JuanMorency/Project_Sij/README.md

# Project_Sij
Complete 600 mm Frame Drone Electrical and Sotware Design using:

- Atmega2560
- MPU9255
- 4 channel RF receiver
- Flycopter 30A BH-heli motor controllers
- WS2812B LED strips
- Madgwick Sensor Fusion

PCB was designed using Eagle. 

Second iteration of the board with much more processing power for sensor fusion should be considered to continue this project
