JuanMorency/Project_Sij/Materiel et magasinage/Liste_de_materiel.txt

Matériel           Responsable

Batteries           Juan
http://www.hobbyking.com/hobbyking/store/__84112__Multistar_LiHV_High_Capacity_5200Mah_3S_Multi_Rotor_Lipo_Pack_US_Warehouse_.html
Frame               Simon
http://www.hobbyking.com/hobbyking/store/__24227__HobbyKing_X666_Glass_Fiber_Quadcopter_Frame_666mm.html
Hélices             Simon
http://www.hobbyking.com/hobbyking/store/__22453__GWS_Style_Slowfly_Propeller_11x4_7_Green_CW_4pcs_.html
prendre 2 CW 2 CCW
Moteurs             Simon/Juan
http://www.hobbyking.com/hobbyking/store/__25081__NTM_Prop_Drive_Series_28_30S_900kv_270w_short_shaft_version_.html
http://www.hobbyking.com/hobbyking/store/__24527__NTM_Prop_Drive_28_Series_Accessory_Pack_US_Warehouse_.html   (Us warehouse)
ESC                 Simon/Juan
http://www.hobbyking.com/hobbyking/store/__94602__Flycolor_Raptor_Mini_30A_F330_Powered_BLHeli_Multi_Rotor_ESC_2_4S_OPTO_.html
Microcontrolleur    Simon
http://www.digikey.ca/product-detail/en/atmel/ATMEGA2560-16AUR/ATMEGA2560-16AURCT-ND/3789436
Breakout board pour MCU
http://www.robotshop.com/ca/en/cytron-qfp-breakout-board-100-pins.html
IMU                 Juan
http://www.robotshop.com/en/imu-10-dof-16g-3-axis-accelerometer-2000-gyro-magnetometer-barometer.html
RF transmitter/receiver
http://www.hobbyking.com/hobbyking/store/__8338__Hobby_King_2_4Ghz_4Ch_Tx_Rx_V2_Mode_2_.html

Optionnel
GPS chip
Wifi/bluetooth chip
Caméra
LCD (utile pour faire des tests)

Battery charger:
http://www.hobbyking.com/hobbyking/store/__95983__Accucell_S60_AC_Charger_US_Plug_.html

Battery bag:
http://www.hobbyking.com/hobbyking/store/__90280__Turnigy_174_Fire_Retardant_LiPoly_Battery_Bag_Zippered_200x155x95mm_1pc_.html

Connectors:
3.5mm bullet conectors 3*4=12 minimum

Heatshrink:

Programmeur:

http://www.robotshop.com/ca/en/pololu-usb-avr-programmer-v2.html

LED strip:

https://www.aliexpress.com/item/individually-addressable-1m-2m-4m-5m-waterproof-ip65-ip67-5050-rgb-30-60-74-96-144/32243894576.html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

crystal:
https://abra-electronics.com/robotics-embedded-electronics/adafruit/components-parts/oscillators-en/2215-ada-16-mhz-crystal-20pf-capacitors.html
