JuanMorency/Project_Sij/Documentation/RF controller/487627402X1231148X58.pdf

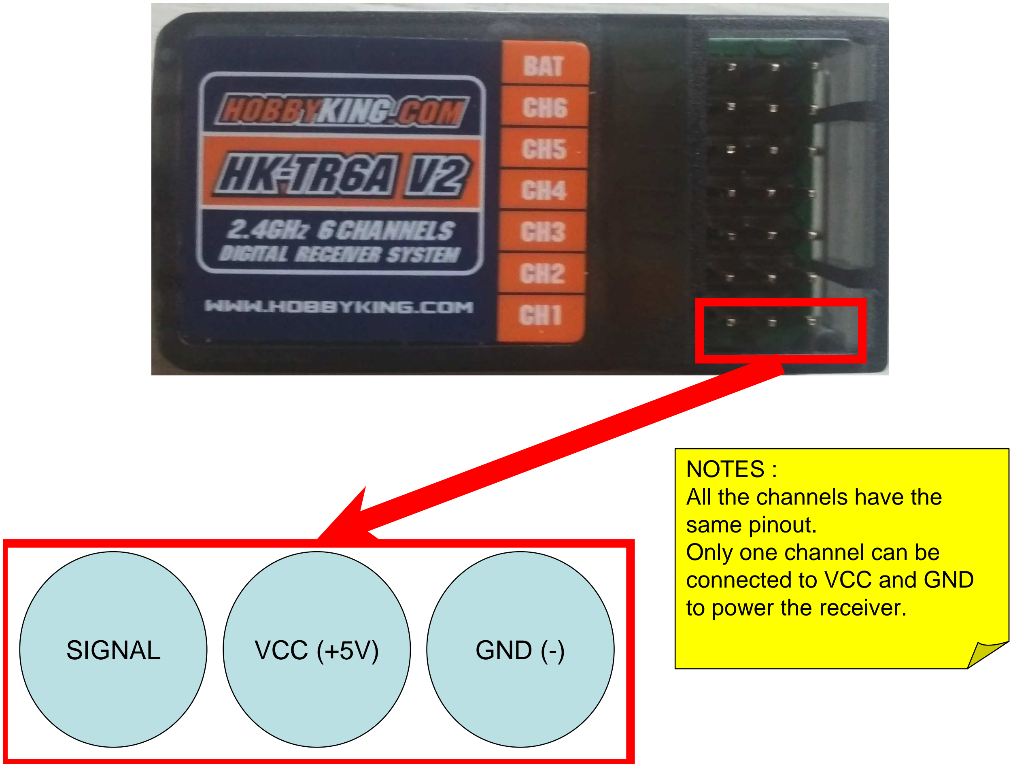
[picture p1: figure]
SIGNAL; VCC (+5V); GND (-); NOTES : All the channels have the same pinout. Only one channel can be connected to VCC and GND to power the receiver.
