JuanMorency/Project_Sij/Eagle/LM5085/2016-09-12_10-49-24/readme.txt

**********************************************************
*************  Important Instructions Follow  ************
**********************************************************

All files exported to: Z:\\43\\47\\4347451\\5\Eagle\2016-09-12_10-49-24\2016-09-12_10-49-24.xml

**********************************************************
*****************Schematic Instructions  *******************
**********************************************************

To import your new Schematic file into Eagle:

1. Unzip the downloaded folder files to local directory and Start Eagle.
2. Select "File"->"Open"->"Schematic..." from the menu at the top of
the screen.
3. Browse to your newly exported file and select the ".sch" file extension.
4. You should now see your schamtic available in Eagle.

**********************************************************
*******************  PCB Instructions  *******************
**********************************************************

To import your new BOARD file into Eagle:

1. Unzip the downloaded folder files to local directory and Start Eagle.
2. Select "File"->"Open"->"Board..." from the menu at the top of
the screen.
3. Browse to your newly exported file and select the ".brd" file extension.
4. Planes will need to be repoured to update the polygon fills
	1. Once your board is loaded and before the repour, the default design rule
	   should be updated for Mask and thermal relief.
		a. Goto Edit and select Design Rules.
			-Select Masks Tab; Set Stop (Min & Max) to 0.0mm
			-Select Supply Tab; Set Thermal Isolation to 0.0mm
	2. To pour the polygon fills, goto Tools and select Ratsnest
	3. The polygons should all be filled now.
5. You should now have an image of your board available in Eagle.

**********************************************************
*******************  LIB Instructions  *******************
**********************************************************

To import your new library into Eagle:

1. Start Eagle.
2. Select "File"->"New"->"Library" from the menu.
3. In the blank library window, select "File" -> "Execute Script"
from the menu.
5. Browse to your newly exported Eagle Script file (".scr" file extension)
6. After opening the file, the script will populate the new library.
Layer 93 should NOT exist.
7. Use "File"->"Save" (or "Save As..") to save the library to the desired
location in Eagle native format.

For additional information, please visit this site:
http://www.accelerated-designs.com/help/Eagle_import.html

You may also find this video helpful:
http://youtu.be/5jGuWY-Yy3Q

**********************************************************
**********************************************************
**********************************************************

Padstack "RX72p08Y137p84D0T" renamed to "RX72p08Y137p84D0"
Padstack "RX420p08Y456p88D0T" renamed to "RX420p08Y456p88D"
Component "GRM188R72E681KW07D" renamed to "GRM188R72E681KW07D"
Component "GRM033R71C102KA01D" renamed to "GRM033R71C102KA01D"
Component "WB_CURRENT_LOAD" renamed to "WB_CURRENT_LOAD"
Component "6TPH100MAEA" renamed to "6TPH100MAEA"
Component "GRM188R61C105KA93D" renamed to "GRM188R61C105KA93D"
Component "MBRB745PBF" renamed to "MBRB745PBF"
Component "WB_GND" renamed to "WB_GND"
Component "XAL6030-222MEB" renamed to "XAL6030-222MEB"
Component "Si7149DP" renamed to "Si7149DP"
Component "CRCW04022K55FKED" renamed to "CRCW04022K55FKED"
Component "CRCW04023K32FKED" renamed to "CRCW04023K32FKED"
Component "CRCW040210K0FKED" renamed to "CRCW040210K0FKED"
Component "CSR1206FK10L0" renamed to "CSR1206FK10L0"
Component "CRCW040226K7FKED" renamed to "CRCW040226K7FKED"
Component "LM5085MY/NOPB" renamed to "LM5085MY/NOPB"
Component "WB_BATTERY" renamed to "WB_BATTERY"
Component "GRM21BR61E475MA12L" renamed to "GRM21BR61E475MA12L"
The Symbol WB_CONTINUATION was missing a RefDes attribute, a refdes was created for the symbol.
The Symbol WB_CONTINUATION was missing a Type attribute, a type was created for the symbol.
The Symbol WB_CONTINUATION was missing a Value attribute, a value was created for the symbol.
The Symbol WB_BLOCK_IO was missing a RefDes attribute, a refdes was created for the symbol.
The Symbol WB_BLOCK_IO was missing a Type attribute, a type was created for the symbol.
The Symbol WB_BLOCK_IO was missing a Value attribute, a value was created for the symbol.
The Symbol WB_PWL_VOLTAGE_SOURCE was missing a RefDes attribute, a refdes was created for the symbol.
The Symbol WB_PWL_VOLTAGE_SOURCE was missing a Type attribute, a type was created for the symbol.
The Symbol WB_PWL_VOLTAGE_SOURCE was missing a Value attribute, a value was created for the symbol.
The Symbol WB_SOURCE_RESISTOR was missing a RefDes attribute, a refdes was created for the symbol.
The Symbol WB_SOURCE_RESISTOR was missing a Type attribute, a type was created for the symbol.
The Symbol WB_SOURCE_RESISTOR was missing a Value attribute, a value was created for the symbol.
The Symbol WB_PRIM_PWL_VOLTAGE_SOURCE was missing a RefDes attribute, a refdes was created for the symbol.
The Symbol WB_PRIM_PWL_VOLTAGE_SOURCE was missing a Type attribute, a type was created for the symbol.
The Symbol WB_PRIM_PWL_VOLTAGE_SOURCE was missing a Value attribute, a value was created for the symbol.
The Symbol WB_CURRENT_PROBE was missing a RefDes attribute, a refdes was created for the symbol.
The Symbol WB_CURRENT_PROBE was missing a Type attribute, a type was created for the symbol.
The Symbol WB_CURRENT_PROBE was missing a Value attribute, a value was created for the symbol.
The Symbol WB_LOAD_RESISTOR was missing a RefDes attribute, a refdes was created for the symbol.
The Symbol WB_LOAD_RESISTOR was missing a Type attribute, a type was created for the symbol.
The Symbol WB_LOAD_RESISTOR was missing a Value attribute, a value was created for the symbol.
The Symbol WB_PRIM_STARTUP_VOLTAGE_SOURCE was missing a RefDes attribute, a refdes was created for the symbol.
The Symbol WB_PRIM_STARTUP_VOLTAGE_SOURCE was missing a Type attribute, a type was created for the symbol.
The Symbol WB_PRIM_STARTUP_VOLTAGE_SOURCE was missing a Value attribute, a value was created for the symbol.
The Symbol WB_STARTUP_VOLTAGE_SOURCE was missing a RefDes attribute, a refdes was created for the symbol.
The Symbol WB_STARTUP_VOLTAGE_SOURCE was missing a Type attribute, a type was created for the symbol.
The Symbol WB_STARTUP_VOLTAGE_SOURCE was missing a Value attribute, a value was created for the symbol.
The Symbol WB_PWL_CURRENT_LOAD was missing a RefDes attribute, a refdes was created for the symbol.
The Symbol WB_PWL_CURRENT_LOAD was missing a Type attribute, a type was created for the symbol.
The Symbol WB_PWL_CURRENT_LOAD was missing a Value attribute, a value was created for the symbol.
The Symbol WB_PRIMITIVE_BATTERY was missing a RefDes attribute, a refdes was created for the symbol.
The Symbol WB_PRIMITIVE_BATTERY was missing a Type attribute, a type was created for the symbol.
The Symbol WB_PRIMITIVE_BATTERY was missing a Value attribute, a value was created for the symbol.
The Symbol WB_CFF_BLOCK was missing a RefDes attribute, a refdes was created for the symbol.
The Symbol WB_CFF_BLOCK was missing a Type attribute, a type was created for the symbol.
The Symbol WB_CFF_BLOCK was missing a Value attribute, a value was created for the symbol.
The Symbol WB_CAP_OUTPUT was missing a RefDes attribute, a refdes was created for the symbol.
The Symbol WB_CAP_OUTPUT was missing a Type attribute, a type was created for the symbol.
The Symbol WB_CAP_OUTPUT was missing a Value attribute, a value was created for the symbol.
The Symbol WB_DIODE_SCHOTTKY was missing a RefDes attribute, a refdes was created for the symbol.
The Symbol WB_DIODE_SCHOTTKY was missing a Type attribute, a type was created for the symbol.
The Symbol WB_DIODE_SCHOTTKY was missing a Value attribute, a value was created for the symbol.
The Symbol WB_P_MOSFET was missing a RefDes attribute, a refdes was created for the symbol.
The Symbol WB_P_MOSFET was missing a Type attribute, a type was created for the symbol.
The Symbol WB_P_MOSFET was missing a Value attribute, a value was created for the symbol.
The Symbol WB_LM5085 was missing a RefDes attribute, a refdes was created for the symbol.
The Symbol WB_LM5085 was missing a Type attribute, a type was created for the symbol.
The Symbol WB_LM5085 was missing a Value attribute, a value was created for the symbol.
The Symbol WB_VOLTAGE_PROBE was missing a RefDes attribute, a refdes was created for the symbol.
The Symbol WB_VOLTAGE_PROBE was missing a Type attribute, a type was created for the symbol.
The Symbol WB_VOLTAGE_PROBE was missing a Value attribute, a value was created for the symbol.
The Symbol LM5085MY/NOPB was missing a Value attribute, a value was created for the symbol.

Ultra Librarian Gold 8.1.44 Process Report

Message - Padstack "RX26Y38D0T" Shape(4) is a CIRCLE with no diameter.
Message - Padstack "RX14Y13D0T" Shape(4) is a CIRCLE with no diameter.
Message - Padstack "RX44Y57D0T" Shape(4) is a CIRCLE with no diameter.
Message - Padstack "RX63Y55D0T" Shape(4) is a CIRCLE with no diameter.
Message - Padstack "RX72p08Y137p84D0" Shape(4) is a CIRCLE with no diameter.
Message - Padstack "RX420p08Y456p88D" Shape(4) is a CIRCLE with no diameter.
Message - Padstack "RX56Y224D0T" Shape(4) is a CIRCLE with no diameter.
Message - Padstack "RX40Y20D0T" Shape(4) is a CIRCLE with no diameter.
Message - Padstack "RX127Y157D0T" Shape(4) is a CIRCLE with no diameter.
Message - Padstack "RX22Y24D0T" Shape(4) is a CIRCLE with no diameter.
Message - Padstack "RX44Y71D0T" Shape(4) is a CIRCLE with no diameter.
Message - Padstack "RX54Y18D0TSM2" Shape(4) is a CIRCLE with no diameter.
Message - Padstack "RX54Y18D0T" Shape(4) is a CIRCLE with no diameter.
Message - Padstack "RX74Y79D0T" Shape(4) is a CIRCLE with no diameter.
Message - Component "GRM188R72E681KW07D" attribute "Cap" references text style "" that is not in the database.
The default pattern text style "H50s3" was substituted.
Message - Component "GRM188R72E681KW07D" attribute "ESR" references text style "" that is not in the database.
The default pattern text style "H50s3" was substituted.
Message - Component "GRM188R72E681KW07D" attribute "IRMS" references text style "" that is not in the database.
The default pattern text style "H50s3" was substituted.
Message - Component "GRM188R72E681KW07D" attribute "VDC" references text style "" that is not in the database.
The default pattern text style "H50s3" was substituted.
Message - Component "GRM033R71C102KA01D" attribute "Cap" references text style "" that is not in the database.
The default pattern text style "H50s3" was substituted.
Message - Component "GRM033R71C102KA01D" attribute "ESR" references text style "" that is not in the database.
The default pattern text style "H50s3" was substituted.
Message - Component "GRM033R71C102KA01D" attribute "IRMS" references text style "" that is not in the database.
The default pattern text style "H50s3" was substituted.
Message - Component "GRM033R71C102KA01D" attribute "VDC" references text style "" that is not in the database.
The default pattern text style "H50s3" was substituted.
Message - Component "6TPH100MAEA" attribute "Datasheet URL" references text style "" that is not in the database.
The default pattern text style "H50s3" was substituted.
Message - Component "6TPH100MAEA" attribute "Cap" references text style "" that is not in the database.
The default pattern text style "H50s3" was substituted.
Message - Component "6TPH100MAEA" attribute "ESR" references text style "" that is not in the database.
The default pattern text style "H50s3" was substituted.
Message - Component "6TPH100MAEA" attribute "IRMS" references text style "" that is not in the database.
The default pattern text style "H50s3" was substituted.
Message - Component "6TPH100MAEA" attribute "VDC" references text style "" that is not in the database.
The default pattern text style "H50s3" was substituted.
Message - Component "GRM188R61C105KA93D" attribute "Cap" references text style "" that is not in the database.
The default pattern text style "H50s3" was substituted.
Message - Component "GRM188R61C105KA93D" attribute "ESR" references text style "" that is not in the database.
The default pattern text style "H50s3" was substituted.
Message - Component "GRM188R61C105KA93D" attribute "IRMS" references text style "" that is not in the database.
The default pattern text style "H50s3" was substituted.
Message - Component "GRM188R61C105KA93D" attribute "VDC" references text style "" that is not in the database.
The default pattern text style "H50s3" was substituted.
Message - Component "MBRB745PBF" attribute "Datasheet URL" references text style "" that is not in the database.
The default pattern text style "H50s3" was substituted.
Message - Component "MBRB745PBF" attribute "Io" references text style "" that is not in the database.
The default pattern text style "H50s3" was substituted.
Message - Component "MBRB745PBF" attribute "VRRM" references text style "" that is not in the database.
The default pattern text style "H50s3" was substituted.
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
Message - Component "LM5085MY/NOPB" attribute "Datasheet URL" references text style "" that is not in the database.
The default pattern text style "H50s3" was substituted.
Message - Component "LM5085MY/NOPB" attribute "Frequency" references text style "" that is not in the database.
The default pattern text style "H50s3" was substituted.
Message - Component "LM5085MY/NOPB" attribute "Imax" references text style "" that is not in the database.
The default pattern text style "H50s3" was substituted.
Message - Component "LM5085MY/NOPB" attribute "Package" references text style "" that is not in the database.
The default pattern text style "H50s3" was substituted.
Message - Component "LM5085MY/NOPB" attribute "Mktg_Package" references text style "" that is not in the database.
The default pattern text style "H50s3" was substituted.
Message - Component "LM5085MY/NOPB" attribute "NSID" references text style "" that is not in the database.
The default pattern text style "H50s3" was substituted.
Message - Component "GRM21BR61E475MA12L" attribute "Datasheet URL" references text style "" that is not in the database.
The default pattern text style "H50s3" was substituted.
Message - Component "GRM21BR61E475MA12L" attribute "Cap" references text style "" that is not in the database.
The default pattern text style "H50s3" was substituted.
Message - Component "GRM21BR61E475MA12L" attribute "ESR" references text style "" that is not in the database.
The default pattern text style "H50s3" was substituted.
Message - Component "GRM21BR61E475MA12L" attribute "IRMS" references text style "" that is not in the database.
The default pattern text style "H50s3" was substituted.
Message - Component "GRM21BR61E475MA12L" attribute "VDC" references text style "" that is not in the database.
The default pattern text style "H50s3" was substituted.

TextStyle count:  24
Padstack count:   14
Pattern count:    10
Symbol count:     27
Component count:  17

Export

Footprint "WB_CURRENT_LOAD" has no layer data mapped and will be skipped.
Component "WB_CURRENT_LOAD" requires footprint "WB_CURRENT_LOAD" and will be skipped.
Footprint "WB_GND" has no layer data mapped and will be skipped.
Component "WB_GND" requires footprint "WB_GND" and will be skipped.
Footprint "WB_BATTERY" has no layer data mapped and will be skipped.
Component "WB_BATTERY" requires footprint "WB_BATTERY" and will be skipped.
