JuanMorency/Project_Sij/Documentation/pushButton.pdf

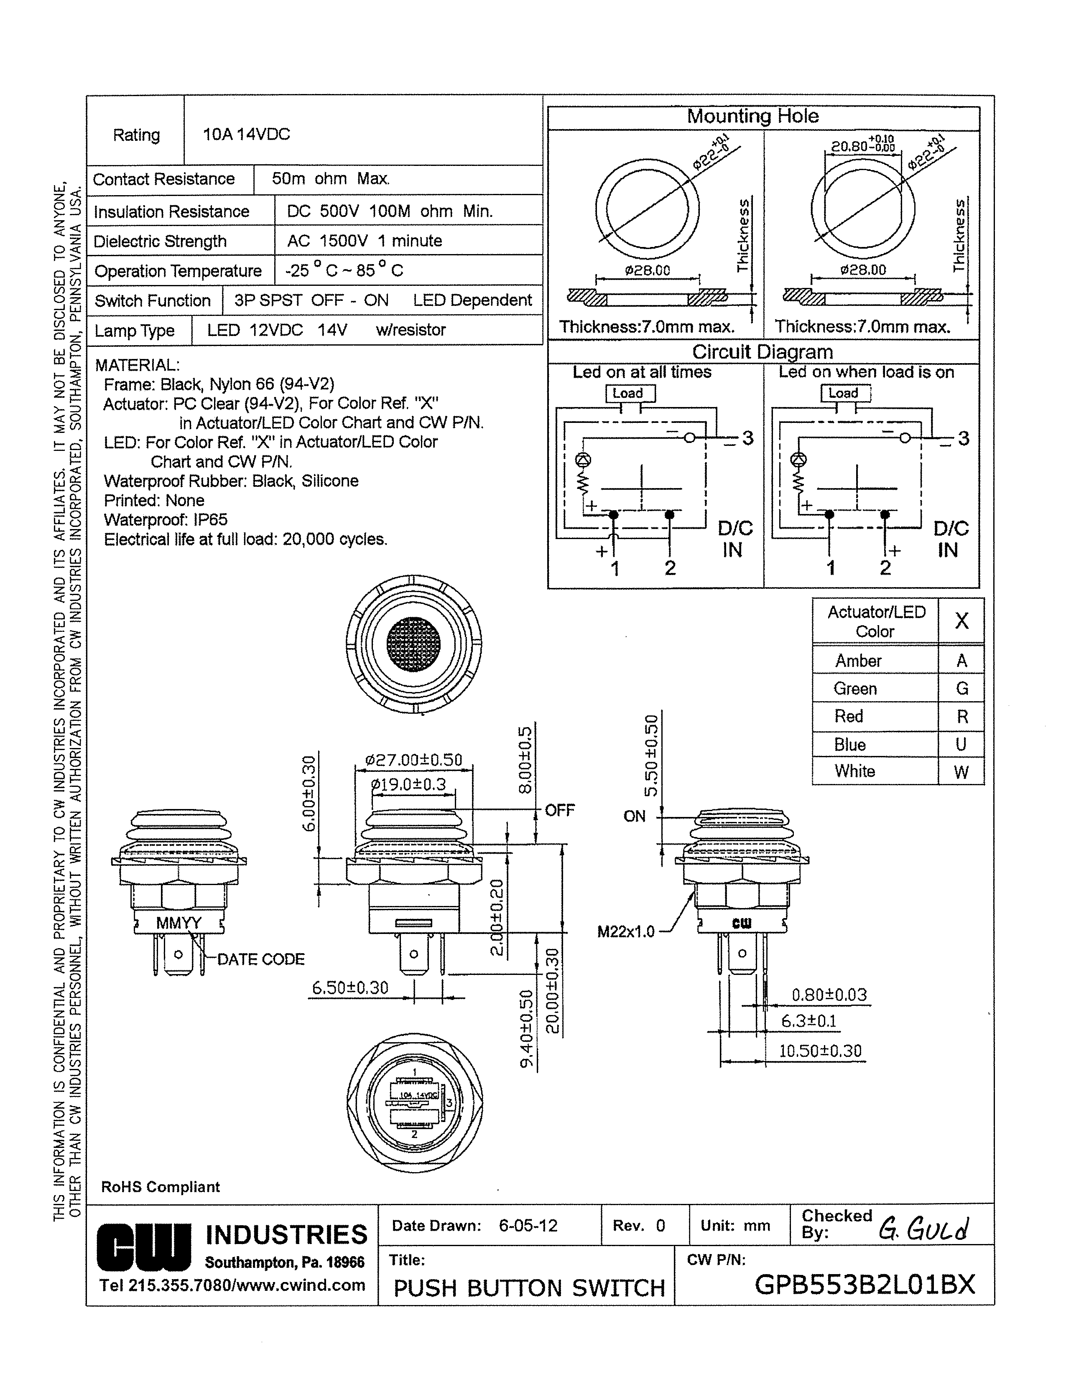
[picture p2: page 1]
