JuanMorency/Project_Sij/Documentation/Coding/filePathMacro.png

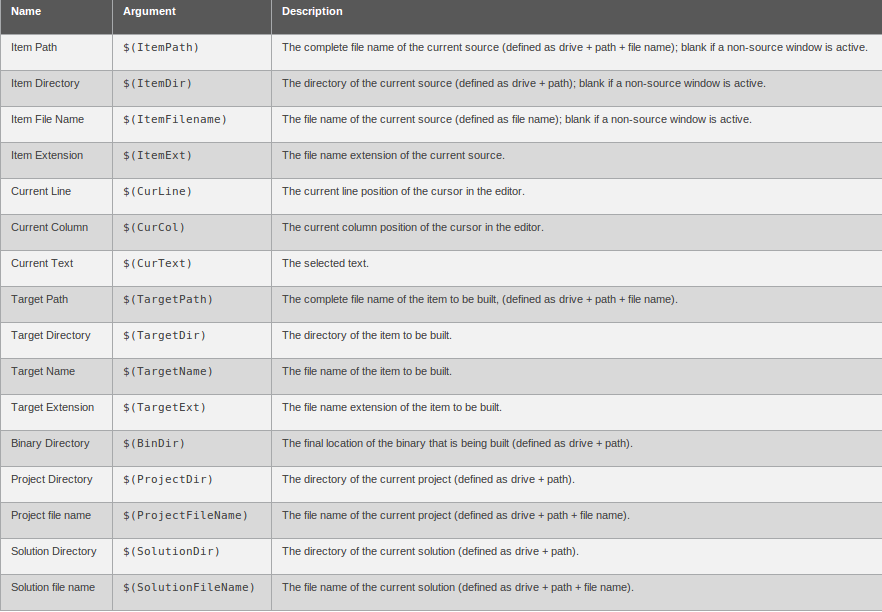
Documentation/Coding/filePathMacro.png
