JuanMorency/Project_Sij/Eagle/Shots/Bottom.PNG

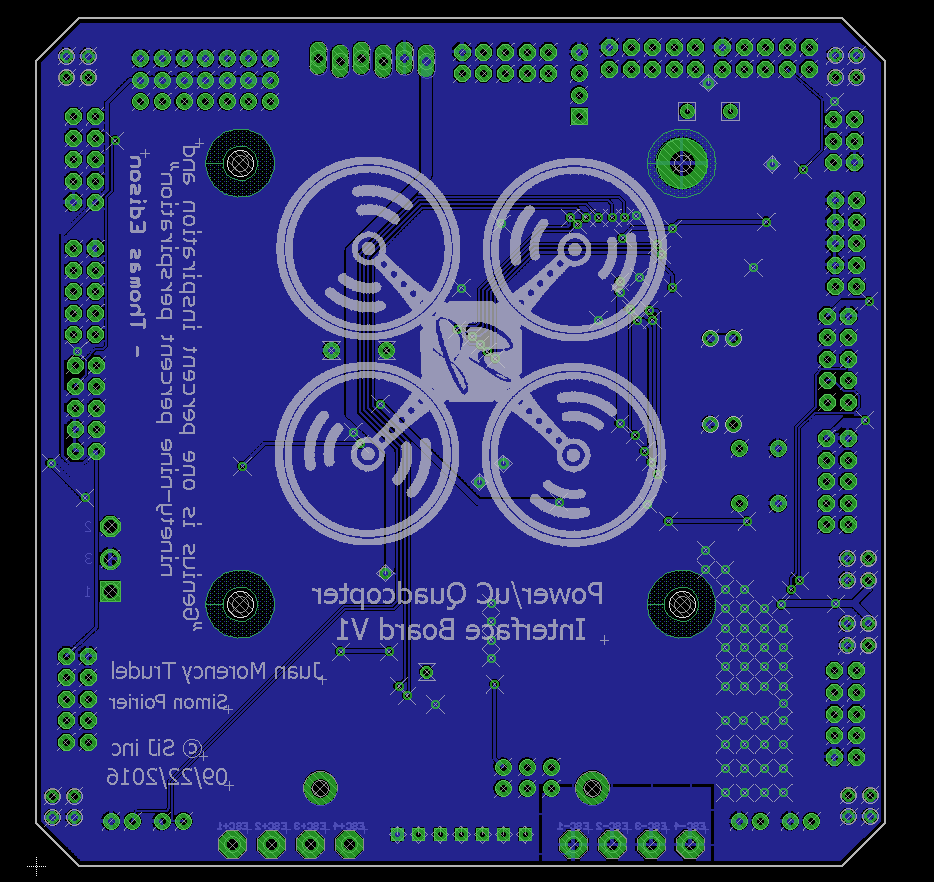
Eagle/Shots/Bottom.PNG
