JuanMorency/Project_Sij/Eagle/Shots/bottom_top.PNG

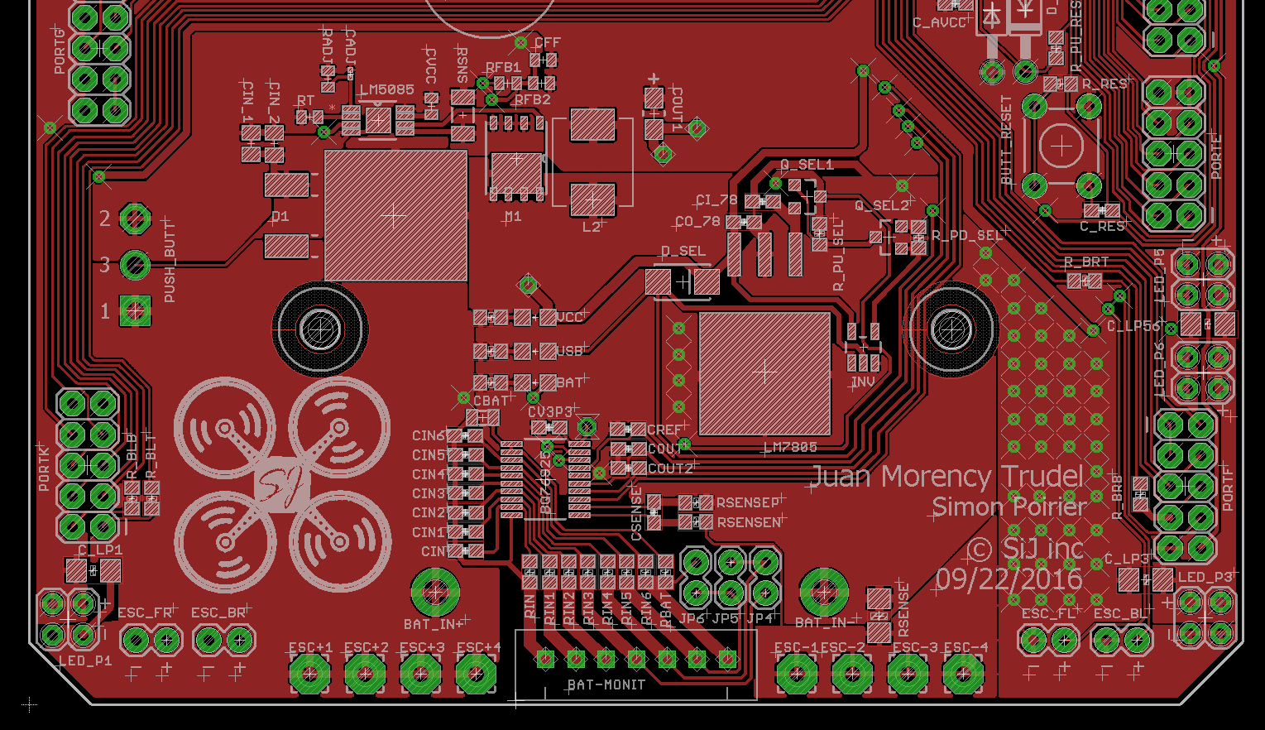
Eagle/Shots/bottom_top.PNG
