JuanMorency/Project_Sij/Eagle/Shots/full_top.PNG

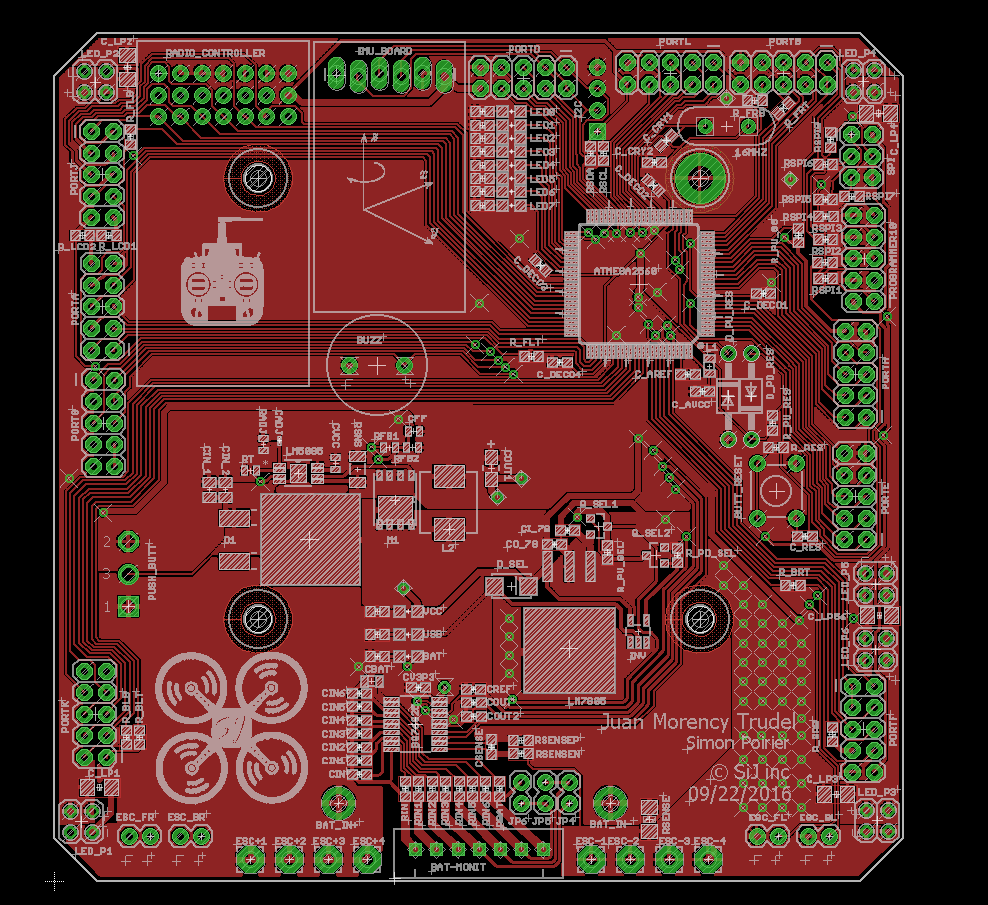
Eagle/Shots/full_top.PNG
