JuanMorency/Project_Sij/Eagle/Shots/top_top.PNG

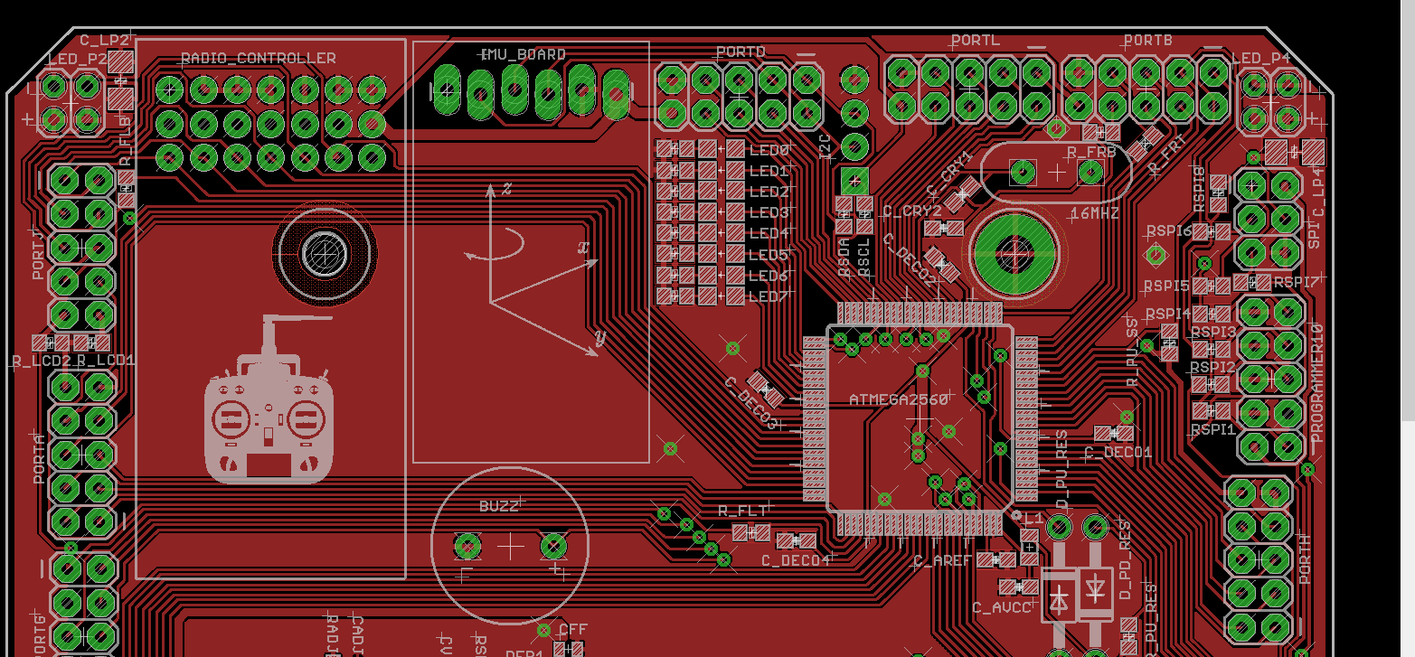
Eagle/Shots/top_top.PNG
