JuanMorency/Project_Sij/Materiel et magasinage/liste_comp_manquante.xlsx

Part | Value | Device | Package | Library | Ordered
16MHZ | 16MHz | CRYSTALHC49US | HC49US | SparkFun-FreqCtrl | y
ATMEGA2560 | ATMEGA2560AU | ATMEGA2560AU | TQFP100 | SparkFun-DigitalIC | y
BAT |  | LEDCHIPLED_0805 | CHIPLED_0805 | led
BAT-MONIT | 7_PIN_JST-XH | 7_PIN_JST-XH | 7_PIN_JST-XH | JST-XH_HEADERS | y
BAT_IN+ | AWG_10_HOLE_PAD | AWG_10_HOLE_PAD | AWG10_HOLE_PAD | custom_parts | y
BAT_IN- | AWG_10_HOLE_PAD | AWG_10_HOLE_PAD | AWG10_HOLE_PAD | custom_parts | y
BQ76925 | BQ76925_PW_20 | BQ76925_PW_20 | PW20 | TI | y
BUTT_RESET | SWITCH-MOMENTARY-2PTH | SWITCH-MOMENTARY-2PTH | TACTILE-PTH | SparkFun-Electromechanical | y
BUZZ | BUZZERPTH | BUZZERPTH | BUZZER-12MM | SparkFun-Electromechanical | y
CADJ | 1nF | GRM033R71C102KA01D | 201 | LM5085 | y
CBAT | 10uF | CAP0805 | 805 | SparkFun-Capacitors | y
CFF | 680pF | GRM188R72E681KW07D | 603 | LM5085
CIN | 1.0uF | 1.0UF-16V-10%(0603) | 0603-CAP | SparkFun-Capacitors | y
CIN1 | 1.0uF | 1.0UF-16V-10%(0603) | 0603-CAP | SparkFun-Capacitors | y
CIN2 | 1.0uF | 1.0UF-16V-10%(0603) | 0603-CAP | SparkFun-Capacitors | y
CIN3 | 1.0uF | 1.0UF-16V-10%(0603) | 0603-CAP | SparkFun-Capacitors | y
CIN4 | 1.0uF | 1.0UF-16V-10%(0603) | 0603-CAP | SparkFun-Capacitors | y
CIN5 | 1.0uF | 1.0UF-16V-10%(0603) | 0603-CAP | SparkFun-Capacitors | y
CIN6 | 1.0uF | 1.0UF-16V-10%(0603) | 0603-CAP | SparkFun-Capacitors | y
CIN_1 | 4.7uF | GRM21BR61E475MA12L | 805 | LM5085 | l
CIN_2 | 4.7uF | GRM21BR61E475MA12L | 805 | LM5085 | l
CI_78 | 0.22uF | 0.22UF-25V-10%(0603) | 0603-CAP | SparkFun-Capacitors | y
COUT | 0.1u | CAP0603-CAP | 0603-CAP | SparkFun-Capacitors | y
COUT1 | 100uF | 6TPH100MAEA | CAPSMT_6_A09 | LM5085 | l
COUT2 | 1.0uF | 1.0UF-16V-10%(0603) | 0603-CAP | SparkFun-Capacitors | y
CO_78 | 0.1uF | 0.1UF-25V-5%(0603) | 0603-CAP | SparkFun-Capacitors | y
CREF | 1.0uF | 1.0UF-16V-10%(0603) | 0603-CAP | SparkFun-Capacitors | y
CSENSE | 0.1u | CAP0603-CAP | 0603-CAP | SparkFun-Passives | y
CV3P3 | 4.7uF | 4.7UF-6.3V-10%(0603)0603 | 0603-CAP | SparkFun-Capacitors | y
CVCC | 1uF | GRM188R61C105KA93D | 603 | LM5085 | y
C_AREF | 0.1u | CAP0603-CAP | 0603-CAP | SparkFun-Capacitors | y
C_AVCC | 0.1u | CAP0603-CAP | 0603-CAP | SparkFun-Capacitors | y
C_CRY1 | 22pF | 22PF-50V-5%(0603) | 0603-CAP | SparkFun-Capacitors | l
C_CRY2 | 22pF | 22PF-50V-5%(0603) | 0603-CAP | SparkFun-Capacitors | l
C_DECO1 | 0.1uF | 0.1UF-25V-5%(0603) | 0603-CAP | SparkFun-Capacitors | y
C_DECO2 | 0.1uF | 0.1UF-25V-5%(0603) | 0603-CAP | SparkFun-Capacitors | y
C_DECO3 | 0.1uF | 0.1UF-25V-5%(0603) | 0603-CAP | SparkFun-Capacitors | y
C_DECO4 | 0.1uF | 0.1UF-25V-5%(0603) | 0603-CAP | SparkFun-Capacitors | y
C_LP1 | 100uF | CAP1206 | 1206 | SparkFun-Capacitors | l
C_LP2 | 100uF | CAP1206 | 1206 | SparkFun-Capacitors | l
C_LP3 | 100uF | CAP1206 | 1206 | SparkFun-Capacitors | l
C_LP4 | 100uF | CAP1206 | 1206 | SparkFun-Capacitors | l
C_LP56 | 100uF | CAP1206 | 1206 | SparkFun-Capacitors | l
C_RES | 0.1uF | 0.1UF-25V-5%(0603) | 0603-CAP | SparkFun-Capacitors | y
D1 | 700mV | MBRB745PBF | DDPAK | LM5085 | l
D_PD_RES | 1N4004 | 1N4004 | DO41-10 | diode | y
D_PU_RES | 1N4004 | 1N4004 | DO41-10 | diode | y
D_SEL | CDBA320L | DIODESMA-ALT | SMA-DIODE_ALT | SparkFun-DiscreteSemi | y
ESC+1 | WIREPAD3,17/1,3 | WIREPAD3,17/1,3 | 3,17/1,3 | wirepad | y
ESC+2 | WIREPAD3,17/1,3 | WIREPAD3,17/1,3 | 3,17/1,3 | wirepad | y
ESC+3 | WIREPAD3,17/1,3 | WIREPAD3,17/1,3 | 3,17/1,3 | wirepad | y
ESC+4 | WIREPAD3,17/1,3 | WIREPAD3,17/1,3 | 3,17/1,3 | wirepad | y
ESC-1 | WIREPAD3,17/1,3 | WIREPAD3,17/1,3 | 3,17/1,3 | wirepad | y
ESC-2 | WIREPAD3,17/1,3 | WIREPAD3,17/1,3 | 3,17/1,3 | wirepad | y
ESC-3 | WIREPAD3,17/1,3 | WIREPAD3,17/1,3 | 3,17/1,3 | wirepad | y
ESC-4 | WIREPAD3,17/1,3 | WIREPAD3,17/1,3 | 3,17/1,3 | wirepad | y
ESC_BL | 640455_TE_connectivity | M02PTH | 1X02 | SparkFun-Connectors | y
ESC_BR | 640455_TE_connectivity | M02PTH | 1X02 | SparkFun-Connectors | y
ESC_FL | 640455_TE_connectivity | M02PTH | 1X02 | SparkFun-Connectors | y
ESC_FR | 640455_TE_connectivity | M02PTH | 1X02 | SparkFun-Connectors | y
H4 | MOUNT-PAD-ROUND3.0 | MOUNT-PAD-ROUND3.0 | 3,0-PAD | holes | y
I2C |  | M041X04_NO_SILK | 1X04_NO_SILK | SparkFun-Connectors | l
IMU_BOARD | M06_IMU | M06_IMU | 1X06_LONGPADS | custom_parts | y
INV | TC7SU04F | INVERTER_SOT23-5 | SOT23-5 | SparkFun-DigitalIC | y
JP4 |  | JUMPER-2PTH | 1X02 | SparkFun-Retired | l
JP5 |  | JUMPER-2PTH | 1X02 | SparkFun-Retired | l
JP6 |  | JUMPER-2PTH | 1X02 | SparkFun-Retired | l
L1 | 10uH | INDUCTOR0805 | 805 | SparkFun-Passives | y
L2 | 2.2uH | IND_MGV0605 | MGV0605 | custom_parts | l
LED0 |  | LEDCHIPLED_0805 | CHIPLED_0805 | led | y
LED1 |  | LEDCHIPLED_0805 | CHIPLED_0805 | led | y
LED2 |  | LEDCHIPLED_0805 | CHIPLED_0805 | led | y
LED3 |  | LEDCHIPLED_0805 | CHIPLED_0805 | led | y
LED4 |  | LEDCHIPLED_0805 | CHIPLED_0805 | led | y
LED5 |  | LEDCHIPLED_0805 | CHIPLED_0805 | led | y
LED6 |  | LEDCHIPLED_0805 | CHIPLED_0805 | led | y
LED7 |  | LEDCHIPLED_0805 | CHIPLED_0805 | led | y
LED_P1 | MALE_HEADER | PINHD-2X2 | 2X02 | pinhead | y
LED_P2 | MALE_HEADER | PINHD-2X2 | 2X02 | pinhead | y
LED_P3 | MALE_HEADER | PINHD-2X2 | 2X02 | pinhead | y
LED_P4 | MALE_HEADER | PINHD-2X2 | 2X02 | pinhead | y
LED_P5 | MALE_HEADER | PINHD-2X2 | 2X02 | pinhead | l
LED_P6 | MALE_HEADER | PINHD-2X2 | 2X02 | pinhead | l
LM5085 | LM5085MY/NOPB | LM5085MY/NOPB | MUY08A | LM5085 | y
LM7805 | LM7805 | LM7805 | KTT3 | TI | y
M1 | -30V | SI7149DP | POWERPAK_SO-8 | LM5085 | l
PORTA |  | M05X2PTH | AVR_ICSP | SparkFun-Connectors | y
PORTB |  | M05X2PTH | AVR_ICSP | SparkFun-Connectors | y
PORTD |  | M05X2PTH | AVR_ICSP | SparkFun-Connectors | y
PORTE |  | M05X2PTH | AVR_ICSP | SparkFun-Connectors | y
PORTF |  | M05X2PTH | AVR_ICSP | SparkFun-Connectors | y
PORTG |  | M05X2PTH | AVR_ICSP | SparkFun-Connectors | y
PORTH |  | M05X2PTH | AVR_ICSP | SparkFun-Connectors | y
PORTJ |  | M05X2PTH | AVR_ICSP | SparkFun-Connectors | y
PORTK |  | M05X2PTH | AVR_ICSP | SparkFun-Connectors | y
PORTL |  | M05X2PTH | AVR_ICSP | SparkFun-Connectors | y
PROGRAMMER10 |  | M05X2PTH | AVR_ICSP | SparkFun-Connectors | y
PUSH_BUTT | PUSH_BUTTON | PUSH_BUTTON | PUSH_BUTTON | custom_parts | l
Q_SEL1 | DMN3099L | MOSFET-PCHANNEL | SOT23-3 | SparkFun-DiscreteSemi | y
Q_SEL2 | DMN3023L | MOSFET-NCHANNELAO3404A | SOT23-3 | SparkFun-DiscreteSemi | y
RADIO_CONTROLLER | RF_CONTROL_3X7_CON | RF_CONTROL_3X7_CON | 3X07 | custom_parts | y
RADJ | 2.55k | CRCW04022K55FKED | 603 | LM5085 | l
RBAT | 100 | R-US_R0603 | R0603 | resistor | y
RFB1 | 3.32k | CRCW04023K32FKED | 603 | LM5085 | l
RFB2 | 10k | CRCW040210K0FKED | 603 | LM5085 | y
RIN | 100 | R-US_R0603 | R0603 | resistor | y
RIN1 | 100 | R-US_R0603 | R0603 | resistor | y
RIN2 | 100 | R-US_R0603 | R0603 | resistor | y
RIN3 | 100 | R-US_R0603 | R0603 | resistor | y
RIN4 | 100 | R-US_R0603 | R0603 | resistor | y
RIN5 | 100 | R-US_R0603 | R0603 | resistor | y
RIN6 | 100 | R-US_R0603 | R0603 | resistor | y
RLED0 |  | R-US_R0603 | R0603 | resistor | y
RLED1 |  | R-US_R0603 | R0603 | resistor | y
RLED2 |  | R-US_R0603 | R0603 | resistor | y
RLED3 |  | R-US_R0603 | R0603 | resistor | y
RLED4 |  | R-US_R0603 | R0603 | resistor | y
RLED5 |  | R-US_R0603 | R0603 | resistor | y
RLED6 |  | R-US_R0603 | R0603 | resistor | y
RLED7 |  | R-US_R0603 | R0603 | resistor | y
RSCL | 2K | R-US_R0603 | R0603 | resistor | y
RSDA | 2K | R-US_R0603 | R0603 | resistor | y
RSENSE | 1m | R-US_R1206 | R1206 | resistor | y
RSENSEN | 1K | R-US_R0603 | R0603 | resistor | y
RSENSEP | 1K | R-US_R0603 | R0603 | resistor | y
RSNS | 10m | CSR1206FK10L0 | 1206 | LM5085 | l
RSPI1 | 500 | R-US_R0603 | R0603 | resistor | n
RSPI2 | 500 | R-US_R0603 | R0603 | resistor | n
RSPI3 | 500 | R-US_R0603 | R0603 | resistor | n
RSPI4 | 500 | R-US_R0603 | R0603 | resistor | n
RSPI5 | 500 | R-US_R0603 | R0603 | resistor | n
RSPI6 | 500 | R-US_R0603 | R0603 | resistor | n
RSPI7 | 500 | R-US_R0603 | R0603 | resistor | n
RSPI8 | 500 | R-US_R0603 | R0603 | resistor | n
RT | 26.7k | CRCW040226K7FKED | 603 | LM5085 | l
R_BAT | to_calc | R-US_R0603 | R0603 | resistor | y
R_BLB | 220 | R-US_R0603 | R0603 | resistor | y
R_BLT | 220 | R-US_R0603 | R0603 | resistor | y
R_BRB | 220 | R-US_R0603 | R0603 | resistor | y
R_BRT | 220 | R-US_R0603 | R0603 | resistor | y
R_FLB | 220 | R-US_R0603 | R0603 | resistor | y
R_FLT | 220 | R-US_R0603 | R0603 | resistor | y
R_FRB | 220 | R-US_R0603 | R0603 | resistor | y
R_FRT | 220 | R-US_R0603 | R0603 | resistor | y
R_LCD1 | 2k | R-US_R0603 | R0603 | resistor | y
R_LCD2 | 500 | R-US_R0603 | R0603 | resistor | n
R_PD_SEL | 10K | R-US_R0603 | R0603 | resistor | y
R_PU_RES | 4.7k | R-US_R0603 | R0603 | resistor | y
R_PU_SEL | 10K | R-US_R0603 | R0603 | resistor | y
R_PU_SS | 4.7k | R-US_R0603 | R0603 | resistor | y
R_RES | 363 | R-US_R0603 | R0603 | resistor | y
R_USB | to_calc | R-US_R0603 | R0603 | resistor | y
R_VCC | to_calc | R-US_R0603 | R0603 | resistor | y
SPI | FEMALE 2x3 | M03X2FEMALE | 2X3 | SparkFun-Connectors | y
USB |  | LEDCHIPLED_0805 | CHIPLED_0805 | led | y
VCC |  | LEDCHIPLED_0805 | CHIPLED_0805 | led | y
