JuanMorency/Project_Sij/(list of files, cad)

Other CAD files:
Code/ExamplesCode/MPU9255-master/i2cdevlib-master/i2cdevlib-master/PIC18/MPU6050/Examples/MPU6050_raw.X/l.obj
