JuanMorency/Project_Sij/Documentation/Coding/Git_merging_tutorial.txt

httpsgit-scm.combookenv2Git-Branching-Basic-Branching-and-Merging
