JuanMorency/Project_Sij/TODO.txt

PCB 

- Verifier le circuit pour le 5V switching regulator. Il fait un bruit aigu et perds en voltage lorsqu'on connecte un load
- Essayer d'arranger le power monitoring I2C en testant sur un un autre board avec notre spare microcontroller

Code

- Voir à rendre le I2C plus robuste.

- Verifier la pertinence d'activer les nested interrupts

- créer des fonctions pour désactiver certain interrupts

- check if we should have some kind of protection when we write 2 bytes in case an interrupt happend in between 
and reads the wrong value.

- Adjust Low pass filter and sampling rate of the accelerometer/gyro.

- Calibration et calculs pour les 3 senseurs
