JuanMorency/Project_Sij/Documentation/documentation-10-dof-imu-sensor-b/10-DOF-IMU-Sensor-B-Schematic.pdf

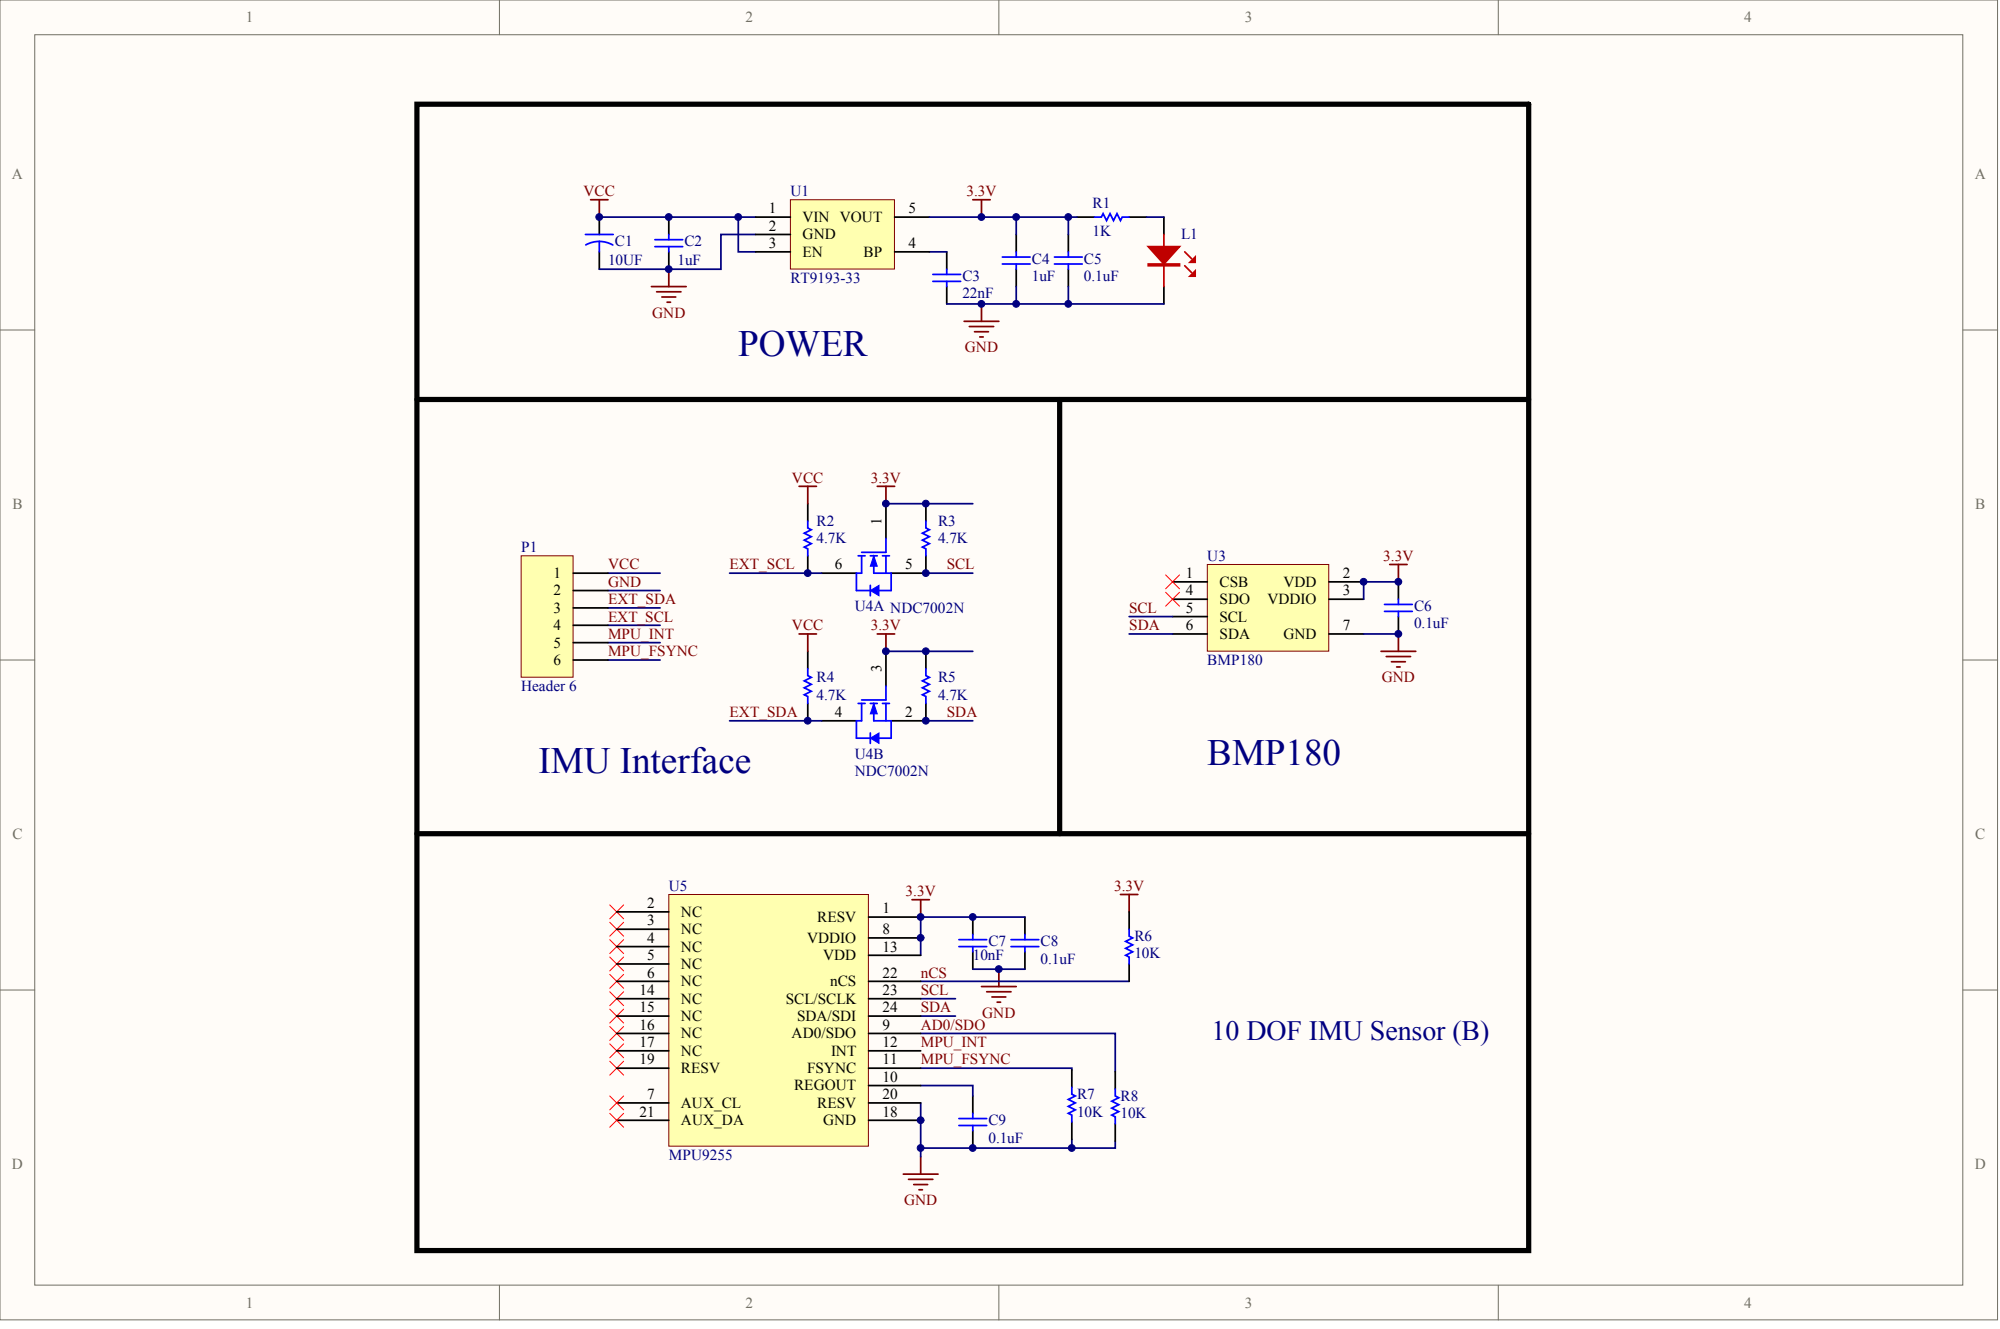
[picture p9: page 1]
