JuanMorency/Project_Sij/Eagle/Projects/Sij/Sij_Final.brd

## EAGLE design Eagle/Projects/Sij/Sij_Final.brd (2016-11-19)

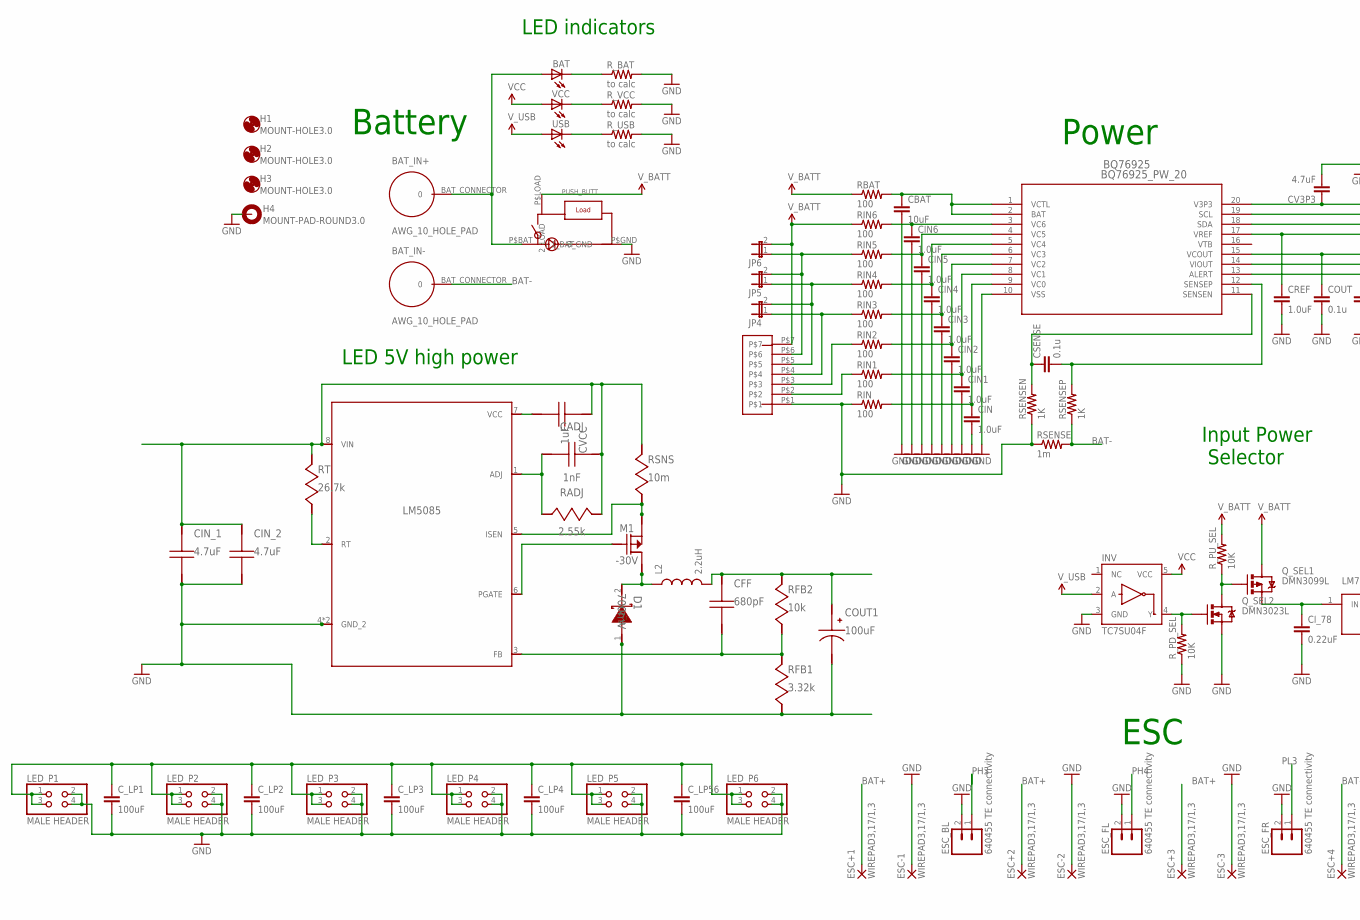
[picture p10: schematic Sij_Final.sch, part in row 1, column 1]

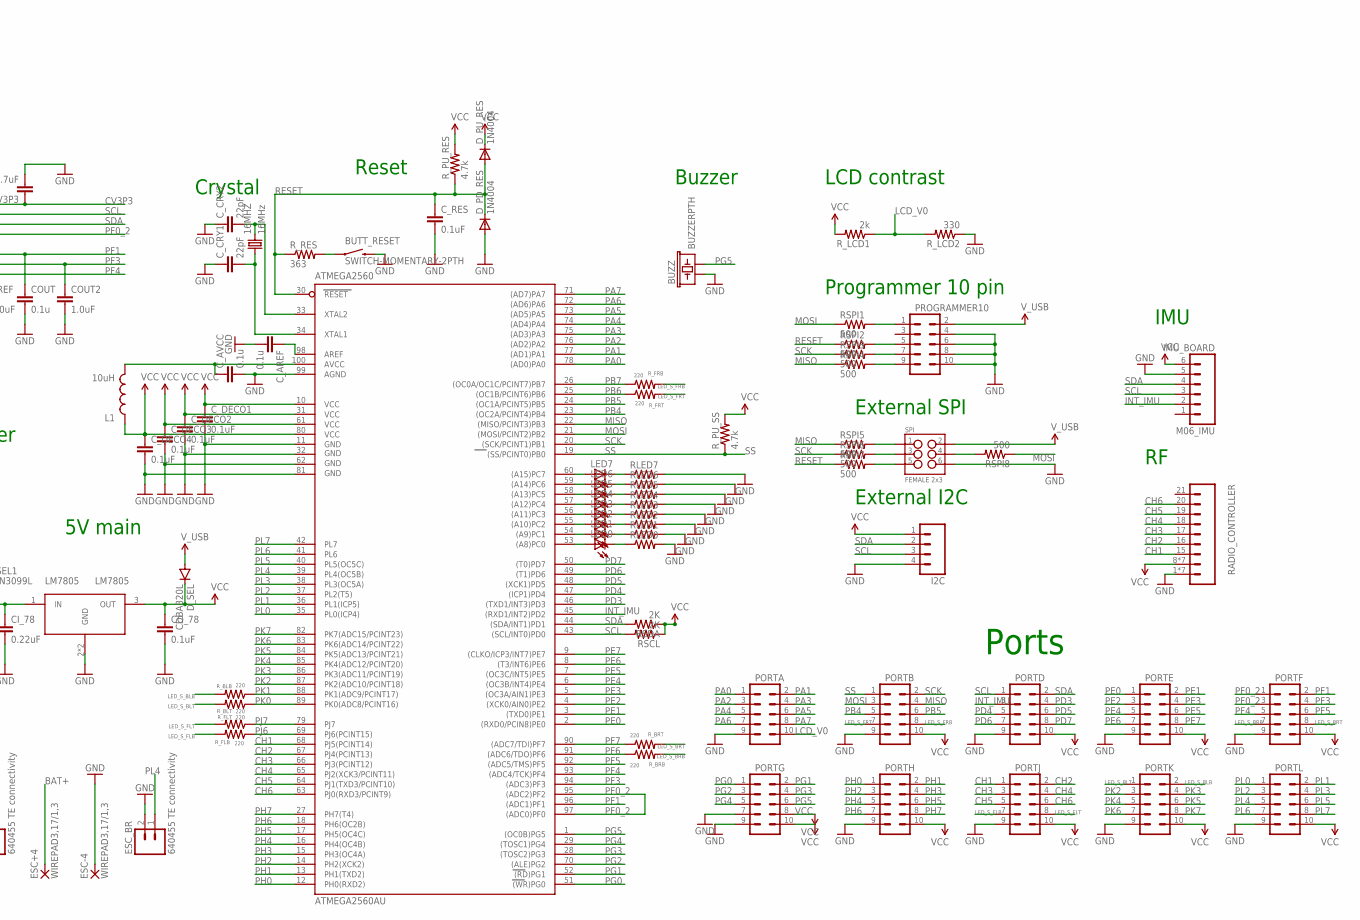
[picture p11: schematic Sij_Final.sch, part in row 1, column 2]

Parts:
16MHZ: 16MHz; HC49US
ATMEGA2560: ATMEGA2560AU; TQFP100
BAT: LEDCHIPLED_0805; CHIPLED_0805
BAT-MONIT: 7_PIN_JST-XH
BAT_IN+: AWG_10_HOLE_PAD; AWG10_HOLE_PAD
BAT_IN-: AWG_10_HOLE_PAD; AWG10_HOLE_PAD
BQ76925: BQ76925_PW_20; PW20
BUTT_RESET: SWITCH-MOMENTARY-2PTH; TACTILE-PTH
BUZZ: BUZZERPTH; BUZZER-12MM
CADJ: 1nF; 0201
CBAT: 10uF; 0805
CFF: 680pF; 0603
CIN, CIN1, CIN2, CIN3, CIN4, CIN5, CIN6: 1.0uF; 0603-CAP
CIN_1, CIN_2: 4.7uF; 0805
CI_78: 0.22uF; 0603-CAP
COUT: 0.1u; 0603-CAP
COUT1: 100uF; CAPSMT_6_A09
COUT2: 1.0uF; 0603-CAP
CO_78: 0.1uF; 0603-CAP
CREF: 1.0uF; 0603-CAP
CSENSE: 0.1u; 0603-CAP
CV3P3: 4.7uF; 0603-CAP
CVCC: 1uF; 0603
C_AREF: 0.1u; 0603-CAP
C_AVCC: 0.1u; 0603-CAP
C_CRY1, C_CRY2: 22pF; 0603-CAP
C_DECO1, C_DECO2, C_DECO3, C_DECO4: 0.1uF; 0603-CAP
C_LP1, C_LP2, C_LP3, C_LP4, C_LP56: 100uF; 1206
C_RES: 0.1uF; 0603-CAP
D1: 700mV; DDPAK
D_PD_RES: 1N4004; DO41-10
D_PU_RES: 1N4004; DO41-10
D_SEL: CDBA320L; SMA-DIODE_ALT
ESC+1, ESC+2, ESC+3, ESC+4: WIREPAD3,17/1,3; 3,17/1,3
ESC-1, ESC-2, ESC-3, ESC-4: WIREPAD3,17/1,3; 3,17/1,3
ESC_BL: 640455 TE connectivity; 1X02
ESC_BR: 640455 TE connectivity; 1X02
ESC_FL: 640455 TE connectivity; 1X02
ESC_FR: 640455 TE connectivity; 1X02
H1, H2, H3: MOUNT-HOLE3.0; 3,0
H4: MOUNT-PAD-ROUND3.0; 3,0-PAD
I2C: M041X04_NO_SILK; 1X04_NO_SILK
IMU_BOARD: M06_IMU; 1X06_LONGPADS
INV: TC7SU04F; SOT23-5
JP4, JP5, JP6: JUMPER-2PTH; 1X02
L1: 10uH; 0805
L2: 2.2uH; MGV0605
LED0, LED1, LED2, LED3, LED4, LED5, LED6, LED7: LEDCHIPLED_0805; CHIPLED_0805
LED_P1, LED_P2, LED_P3, LED_P4, LED_P5, LED_P6: MALE HEADER; 2X02
LM5085: LM5085MY/NOPB; MUY08A
LM7805: LM7805; KTT3
M1: -30V; POWERPAK_SO-8
PORTA: M05X2PTH; AVR_ICSP
PORTB: M05X2PTH; AVR_ICSP
PORTD: M05X2PTH; AVR_ICSP
PORTE: M05X2PTH; AVR_ICSP
PORTF: M05X2PTH; AVR_ICSP
PORTG: M05X2PTH; AVR_ICSP
PORTH: M05X2PTH; AVR_ICSP
PORTJ: M05X2PTH; AVR_ICSP
PORTK: M05X2PTH; AVR_ICSP
PORTL: M05X2PTH; AVR_ICSP
PROGRAMMER10: M05X2PTH; AVR_ICSP
PUSH_BUTT: PUSH_BUTTON
Q_SEL1: DMN3099L; SOT23-3
Q_SEL2: DMN3023L; SOT23-3
RADIO_CONTROLLER: RF_CONTROL_3X7_CON; 3X07
RADJ: 2.55k; 0603
RBAT: 100; R0603
RFB1: 3.32k; 0603
RFB2: 10k; 0603
RIN, RIN1, RIN2, RIN3, RIN4, RIN5, RIN6: 100; R0603
RLED0, RLED1, RLED2, RLED3, RLED4, RLED5, RLED6, RLED7: R-US_R0603; R0603
RSCL: 2K; R0603
RSDA: 2K; R0603
RSENSE: 1m; R1206
RSENSEN: 1K; R0603
RSENSEP: 1K; R0603
RSNS: 10m; 1206
RSPI1, RSPI2, RSPI3, RSPI4, RSPI5, RSPI6, RSPI7, RSPI8: 500; R0603
RT: 26.7k; 0603
R_BAT: to calc; R0603
R_BLB: 220; R0603
R_BLT: 220; R0603
R_BRB: 220; R0603
R_BRT: 220; R0603
R_FLB: 220; R0603
R_FLT: 220; R0603
R_FRB: 220; R0603
R_FRT: 220; R0603
R_LCD1: 2k; R0603
R_LCD2: 330; R0603
R_PD_SEL: 10K; R0603
R_PU_RES: 4.7k; R0603
R_PU_SEL: 10K; R0603
R_PU_SS: 4.7k; R0603
R_RES: 363; R0603
R_USB: to calc; R0603
R_VCC: to calc; R0603
SPI: FEMALE 2x3; 2X3
USB: LEDCHIPLED_0805; CHIPLED_0805
VCC: LEDCHIPLED_0805; CHIPLED_0805

Connections:
9_5085: D1.2 (K), L2.P$1 (1), M1.5 (DRAIN_2), M1.6 (DRAIN_2), M1.7 (DRAIN_2), M1.8 (DRAIN_2), M1.9 (DRAIN_2)
ADJ_1085: CADJ.2, LM5085.1 (ADJ), RADJ.2
BAT+: BAT.A, BAT_IN+.BAT_CONNECTOR, ESC+1.1, ESC+2.1, ESC+3.1, ESC+4.1, PUSH_BUTT.P$BAT (1_BAT)
BAT-: BAT_IN-.BAT_CONNECTOR, RSENSE.2, RSENSEP.1
CH1: ATMEGA2560.68 (PJ5(PCINT14)), PORTJ.1, RADIO_CONTROLLER.15 (1)
CH2: ATMEGA2560.67 (PJ4(PCINT13)), PORTJ.2, RADIO_CONTROLLER.16 (2)
CH3: ATMEGA2560.66 (PJ3(PCINT12)), PORTJ.3, RADIO_CONTROLLER.17 (3)
CH4: ATMEGA2560.65 (PJ2(XCK3/PCINT11)), PORTJ.4, RADIO_CONTROLLER.18 (4)
CH5: ATMEGA2560.64 (PJ1(TXD3/PCINT10)), PORTJ.5, RADIO_CONTROLLER.19 (5)
CH6: ATMEGA2560.63 (PJ0(RXD3/PCINT9)), PORTJ.6, RADIO_CONTROLLER.20 (6)
CV3P3: BQ76925.20 (V3P3), CV3P3.1
FB_5085: CFF.2, LM5085.3 (FB), RFB1.1, RFB2.2
GND: ATMEGA2560.11 (GND), ATMEGA2560.32 (GND1), ATMEGA2560.62 (GND2), ATMEGA2560.81 (GND3), ATMEGA2560.99 (AGND), BAT-MONIT.P$1, BQ76925.10 (VSS), BUTT_RESET.3 (2), BUTT_RESET.4 (2), BUZZ.+ (1), CBAT.2, CIN.2, CIN1.2, CIN2.2, CIN3.2, CIN4.2, CIN5.2, CIN6.2, CIN_1.2, CIN_2.2, CI_78.2, COUT.2, COUT1.2 (-), COUT2.2, CO_78.2, CREF.2, CV3P3.2, C_AREF.2, C_AVCC.2, C_CRY1.1, C_CRY2.1, C_DECO1.2, C_DECO2.2, C_DECO3.2, C_DECO4.2, C_LP1.2, C_LP2.2, C_LP3.2, C_LP4.2, C_LP56.2, C_RES.2, D1.1 (A_2), D_PD_RES.A, ESC-1.1, ESC-2.1, ESC-3.1, ESC-4.1, ESC_BL.2, ESC_BR.2, ESC_FL.2, ESC_FR.2, H4.B3,0, I2C.4, IMU_BOARD.5, INV.3 (GND), LED_P1.2, LED_P1.4, LED_P2.2, LED_P2.4, LED_P3.2, LED_P3.4, LED_P4.2, LED_P4.4, LED_P5.2, LED_P5.4, LED_P6.2, LED_P6.4, LM5085.4 (GND_2), LM5085.9 (GND_2), LM7805.2 (GND), LM7805.4 (GND), PORTA.9, PORTB.9, PORTD.9, PORTE.9, PORTF.9, PORTG.7, PORTG.9, PORTH.9, PORTJ.9, PORTK.9, PORTL.9, PROGRAMMER10.4, PROGRAMMER10.6, PROGRAMMER10.8, PROGRAMMER10.10, PUSH_BUTT.P$GND (3_GND), Q_SEL2.2 (S), RADIO_CONTROLLER.1 (GND), RADIO_CONTROLLER.2 (GND), RADIO_CONTROLLER.3 (GND), RADIO_CONTROLLER.4 (GND), RADIO_CONTROLLER.5 (GND), RADIO_CONTROLLER.6 (GND), RADIO_CONTROLLER.7 (GND), RFB1.2, RIN.1, RLED0.2, RLED1.2, RLED2.2, RLED3.2, RLED4.2, RLED5.2, RLED6.2, RLED7.2, RSENSE.1, RSENSEN.1, R_BAT.2, R_LCD2.1, R_PD_SEL.1, R_USB.2, R_VCC.2, SPI.6
INT_IMU: ATMEGA2560.45 ((RXD1/INT2)PD2), IMU_BOARD.2, PORTD.3
ISEN_5085: LM5085.5 (ISEN), M1.1 (SOURCE_2), M1.2 (SOURCE_2), M1.3 (SOURCE_2), RSNS.2
LCD_V0: PORTA.10, R_LCD1.1, R_LCD2.2
LED_S_BLB: PORTK.2, R_BLB.2
LED_S_BLT: PORTK.1, R_BLT.2
LED_S_BRB: PORTF.7, R_BRB.2
LED_S_BRT: PORTF.8, R_BRT.2
LED_S_FLB: PORTJ.7, R_FLB.2
LED_S_FLT: PORTJ.8, R_FLT.2
LED_S_FRB: PORTB.8, R_FRB.2
LED_S_FRT: PORTB.7, R_FRT.2
MISO: ATMEGA2560.22 ((MISO/PCINT3)PB3), PORTB.4, RSPI4.1, RSPI5.1
MOSI: ATMEGA2560.21 ((MOSI/PCINT2)PB2), PORTB.3, RSPI1.1, RSPI8.1
unnamed: PROGRAMMER10.7, RSPI3.2
unnamed: PROGRAMMER10.1, RSPI1.2
unnamed: PROGRAMMER10.9, RSPI4.2
unnamed: CI_78.1, LM7805.1 (IN), Q_SEL1.2 (S)
unnamed: ATMEGA2560.100 (AVCC), C_AVCC.1, L1.2
unnamed: 16MHZ.1, ATMEGA2560.34 (XTAL1), C_CRY1.2
unnamed: BQ76925.6 (VC3), CIN3.1, RIN3.2
unnamed: BQ76925.1 (VCTL), BQ76925.2 (BAT), CBAT.1, RBAT.2
unnamed: BQ76925.7 (VC2), CIN2.1, RIN2.2
unnamed: BQ76925.8 (VC1), CIN1.1, RIN1.2
unnamed: BQ76925.9 (VC0), CIN.1, RIN.2
unnamed: BQ76925.5 (VC4), CIN4.1, RIN4.2
unnamed: INV.4 (Y), Q_SEL2.1 (G), R_PD_SEL.2
unnamed: ATMEGA2560.60 ((A15)PC7), LED7.A
unnamed: BQ76925.11 (SENSEN), CSENSE.1, RSENSEN.2
unnamed: BQ76925.12 (SENSEP), CSENSE.2, RSENSEP.2
unnamed: BQ76925.3 (VC6), CIN6.1, RIN6.2
unnamed: BQ76925.4 (VC5), CIN5.1, RIN5.2
unnamed: ATMEGA2560.59 ((A14)PC6), LED6.A
unnamed: ATMEGA2560.58 ((A13)PC5), LED5.A
unnamed: ATMEGA2560.57 ((A12)PC4), LED4.A
unnamed: ATMEGA2560.56 ((A11)PC3), LED3.A
unnamed: BAT-MONIT.P$2, RIN1.1
unnamed: RSPI8.2, SPI.4
unnamed: ATMEGA2560.55 ((A10)PC2), LED2.A
unnamed: ATMEGA2560.54 ((A9)PC1), LED1.A
unnamed: BAT-MONIT.P$3, RIN2.1
unnamed: BAT-MONIT.P$4, JP4.1, RIN3.1
unnamed: BAT-MONIT.P$5, JP4.2, JP5.1, RIN4.1
unnamed: BAT-MONIT.P$6, JP5.2, JP6.1, RIN5.1
unnamed: ATMEGA2560.53 ((A8)PC0), LED0.A
unnamed: BUTT_RESET.1, BUTT_RESET.2 (1), R_RES.2
unnamed: R_USB.1, USB.C
unnamed: 16MHZ.2, ATMEGA2560.33 (XTAL2), C_CRY2.2
unnamed: Q_SEL1.1 (G), Q_SEL2.3 (D), R_PU_SEL.1
unnamed: R_VCC.1, VCC.C
unnamed: LED7.C, RLED7.1
unnamed: LED6.C, RLED6.1
unnamed: LED5.C, RLED5.1
unnamed: RSPI6.2, SPI.3
unnamed: LED4.C, RLED4.1
unnamed: LED3.C, RLED3.1
unnamed: LED2.C, RLED2.1
unnamed: LED1.C, RLED1.1
unnamed: LED0.C, RLED0.1
unnamed: BAT.C, R_BAT.1
unnamed: RSPI5.2, SPI.1
unnamed: PROGRAMMER10.5, RSPI2.2
unnamed: ATMEGA2560.98 (AREF), C_AREF.1
unnamed: RSPI7.2, SPI.5
PA0: ATMEGA2560.78 ((AD0)PA0), PORTA.1
PA1: ATMEGA2560.77 ((AD1)PA1), PORTA.2
PA2: ATMEGA2560.76 ((AD2)PA2), PORTA.3
PA3: ATMEGA2560.75 ((AD3)PA3), PORTA.4
PA4: ATMEGA2560.74 ((AD4)PA4), PORTA.5
PA5: ATMEGA2560.73 ((AD5)PA5), PORTA.6
PA6: ATMEGA2560.72 ((AD6)PA6), PORTA.7
PA7: ATMEGA2560.71 ((AD7)PA7), PORTA.8
PB4: ATMEGA2560.23 ((OC2A/PCINT4)PB4), PORTB.5
PB5: ATMEGA2560.24 ((OC1A/PCINT5)PB5), PORTB.6
PB6: ATMEGA2560.25 ((OC1B/PCINT6)PB6), R_FRT.1
PB7: ATMEGA2560.26 ((OC0A/OC1C/PCINT7)PB7), R_FRB.1
PD3: ATMEGA2560.46 ((TXD1/INT3)PD3), PORTD.4
PD4: ATMEGA2560.47 ((ICP1)PD4), PORTD.5
PD5: ATMEGA2560.48 ((XCK1)PD5), PORTD.6
PD6: ATMEGA2560.49 ((T1)PD6), PORTD.7
PD7: ATMEGA2560.50 ((T0)PD7), PORTD.8
PE0: ATMEGA2560.2 ((RXD0/PCIN8)PE0), PORTE.1
PE1: ATMEGA2560.3 ((TXD0)PE1), PORTE.2
PE2: ATMEGA2560.4 ((XCK0/AIN0)PE2), PORTE.3
PE3: ATMEGA2560.5 ((OC3A/AIN1)PE3), PORTE.4
PE4: ATMEGA2560.6 ((OC3B/INT4)PE4), PORTE.5
PE5: ATMEGA2560.7 ((OC3C/INT5)PE5), PORTE.6
PE6: ATMEGA2560.8 ((T3/INT6)PE6), PORTE.7
PE7: ATMEGA2560.9 ((CLKO/ICP3/INT7)PE7), PORTE.8
PF0_2: ATMEGA2560.95 ((ADC2)PF2), ATMEGA2560.97 ((ADC0)PF0), BQ76925.17 (VREF), CREF.1, PORTF.1, PORTF.3
PF1: ATMEGA2560.96 ((ADC1)PF1), BQ76925.15 (VCOUT), COUT.1, PORTF.2
PF3: ATMEGA2560.94 ((ADC3)PF3), BQ76925.14 (VIOUT), COUT2.1, PORTF.4
PF4: ATMEGA2560.93 ((ADC4/TCK)PF4), BQ76925.13 (ALERT), PORTF.5
PF5: ATMEGA2560.92 ((ADC5/TMS)PF5), PORTF.6
PF6: ATMEGA2560.91 ((ADC6/TDO)PF6), R_BRB.1
PF7: ATMEGA2560.90 ((ADC7/TDI)PF7), R_BRT.1
PG0: ATMEGA2560.51 ((WR)PG0), PORTG.1
PG1: ATMEGA2560.52 ((RD)PG1), PORTG.2
PG2: ATMEGA2560.70 ((ALE)PG2), PORTG.3
PG3: ATMEGA2560.28 ((TOSC2)PG3), PORTG.4
PG4: ATMEGA2560.29 ((TOSC1)PG4), PORTG.5
PG5: ATMEGA2560.1 ((OC0B)PG5), BUZZ.- (2), PORTG.6
PGATE_5085: LM5085.6 (PGATE), M1.4 (GATE)
PH0: ATMEGA2560.12 (PH0(RXD2)), PORTH.1
PH1: ATMEGA2560.13 (PH1(TXD2)), PORTH.2
PH2: ATMEGA2560.14 (PH2(XCK2)), PORTH.3
PH3: ATMEGA2560.15 (PH3(OC4A)), ESC_BL.1, PORTH.4
PH4: ATMEGA2560.16 (PH4(OC4B)), ESC_FL.1, PORTH.5
PH5: ATMEGA2560.17 (PH5(OC4C)), PORTH.6
PH6: ATMEGA2560.18 (PH6(OC2B)), PORTH.7
PH7: ATMEGA2560.27 (PH7(T4)), PORTH.8
PJ6: ATMEGA2560.69 (PJ6(PCINT15)), R_FLB.1
PJ7: ATMEGA2560.79 (PJ7), R_FLT.1
PK0: ATMEGA2560.89 (PK0(ADC8/PCINT16)), R_BLT.1
PK1: ATMEGA2560.88 (PK1(ADC9/PCINT17)), R_BLB.1
PK2: ATMEGA2560.87 (PK2(ADC10/PCINT18)), PORTK.3
PK3: ATMEGA2560.86 (PK3(ADC11/PCINT19)), PORTK.4
PK4: ATMEGA2560.85 (PK4(ADC12/PCINT20)), PORTK.5
PK5: ATMEGA2560.84 (PK5(ADC13/PCINT21)), PORTK.6
PK6: ATMEGA2560.83 (PK6(ADC14/PCINT22)), PORTK.7
PK7: ATMEGA2560.82 (PK7(ADC15/PCINT23)), PORTK.8
PL0: ATMEGA2560.35 (PL0(ICP4)), PORTL.1
PL1: ATMEGA2560.36 (PL1(ICP5)), PORTL.2
PL2: ATMEGA2560.37 (PL2(T5)), PORTL.3
PL3: ATMEGA2560.38 (PL3(OC5A)), ESC_FR.1, PORTL.4
PL4: ATMEGA2560.39 (PL4(OC5B)), ESC_BR.1, PORTL.5
PL5: ATMEGA2560.40 (PL5(OC5C)), PORTL.6
PL6: ATMEGA2560.41 (PL6), PORTL.7
PL7: ATMEGA2560.42 (PL7), PORTL.8
RESET: ATMEGA2560.30 (RESET), C_RES.1, D_PD_RES.C, D_PU_RES.A, RSPI2.1, RSPI7.1, R_PU_RES.1, R_RES.1
RT_5085: LM5085.2 (RT), RT.2
SCK: ATMEGA2560.20 ((SCK/PCINT1)PB1), PORTB.2, RSPI3.1, RSPI6.1
SCL: ATMEGA2560.43 ((SCL/INT0)PD0), BQ76925.19 (SCL), I2C.3, IMU_BOARD.3, PORTD.1, RSCL.2
SDA: ATMEGA2560.44 ((SDA/INT1)PD1), BQ76925.18 (SDA), I2C.2, IMU_BOARD.4, PORTD.2, RSDA.2
SS: ATMEGA2560.19 ((SS/PCINT0)PB0), PORTB.1, R_PU_SS.1
VCC: ATMEGA2560.10 (VCC), ATMEGA2560.31 (VCC1), ATMEGA2560.61 (VCC2), ATMEGA2560.80 (VCC3), CO_78.1, C_DECO1.1, C_DECO2.1, C_DECO3.1, C_DECO4.1, D_PU_RES.C, D_SEL.C, I2C.1, IMU_BOARD.6, INV.5 (VCC), L1.1, LM7805.3 (OUT), PORTB.10, PORTD.10, PORTE.10, PORTF.10, PORTG.8, PORTG.10, PORTH.10, PORTJ.10, PORTK.10, PORTL.10, RADIO_CONTROLLER.8 (5V), RADIO_CONTROLLER.9 (5V), RADIO_CONTROLLER.10 (5V), RADIO_CONTROLLER.11 (5V), RADIO_CONTROLLER.12 (5V), RADIO_CONTROLLER.13 (5V), RADIO_CONTROLLER.14 (5V), RSCL.1, RSDA.1, R_LCD1.2, R_PU_RES.2, R_PU_SS.2, VCC.A
VCC_1085: CVCC.2, LM5085.7 (VCC)
VOUT_5085: CFF.1, COUT1.1 (+), C_LP1.1, C_LP2.1, C_LP3.1, C_LP4.1, C_LP56.1, L2.P$2 (2), LED_P1.1, LED_P1.3, LED_P2.1, LED_P2.3, LED_P3.1, LED_P3.3, LED_P4.1, LED_P4.3, LED_P5.1, LED_P5.3, LED_P6.1, LED_P6.3, RFB2.1
V_BATT: BAT-MONIT.P$7, CADJ.1, CIN_1.1, CIN_2.1, CVCC.1, JP6.2, LM5085.8 (VIN), PUSH_BUTT.P$LOAD (2_LOAD), Q_SEL1.3 (D), RADJ.1, RBAT.1, RIN6.1, RSNS.1, RT.1, R_PU_SEL.2
V_USB: D_SEL.A, INV.2 (A), PROGRAMMER10.2, SPI.2, USB.A

Notes on the sheet:
ESC
Power
Battery
LED indicators
IMU
Programmer 10 pin
Reset
Crystal
External SPI
External I2C
5V main
LED 5V high power
Input Power Selector
Ports
Buzzer
LCD contrast

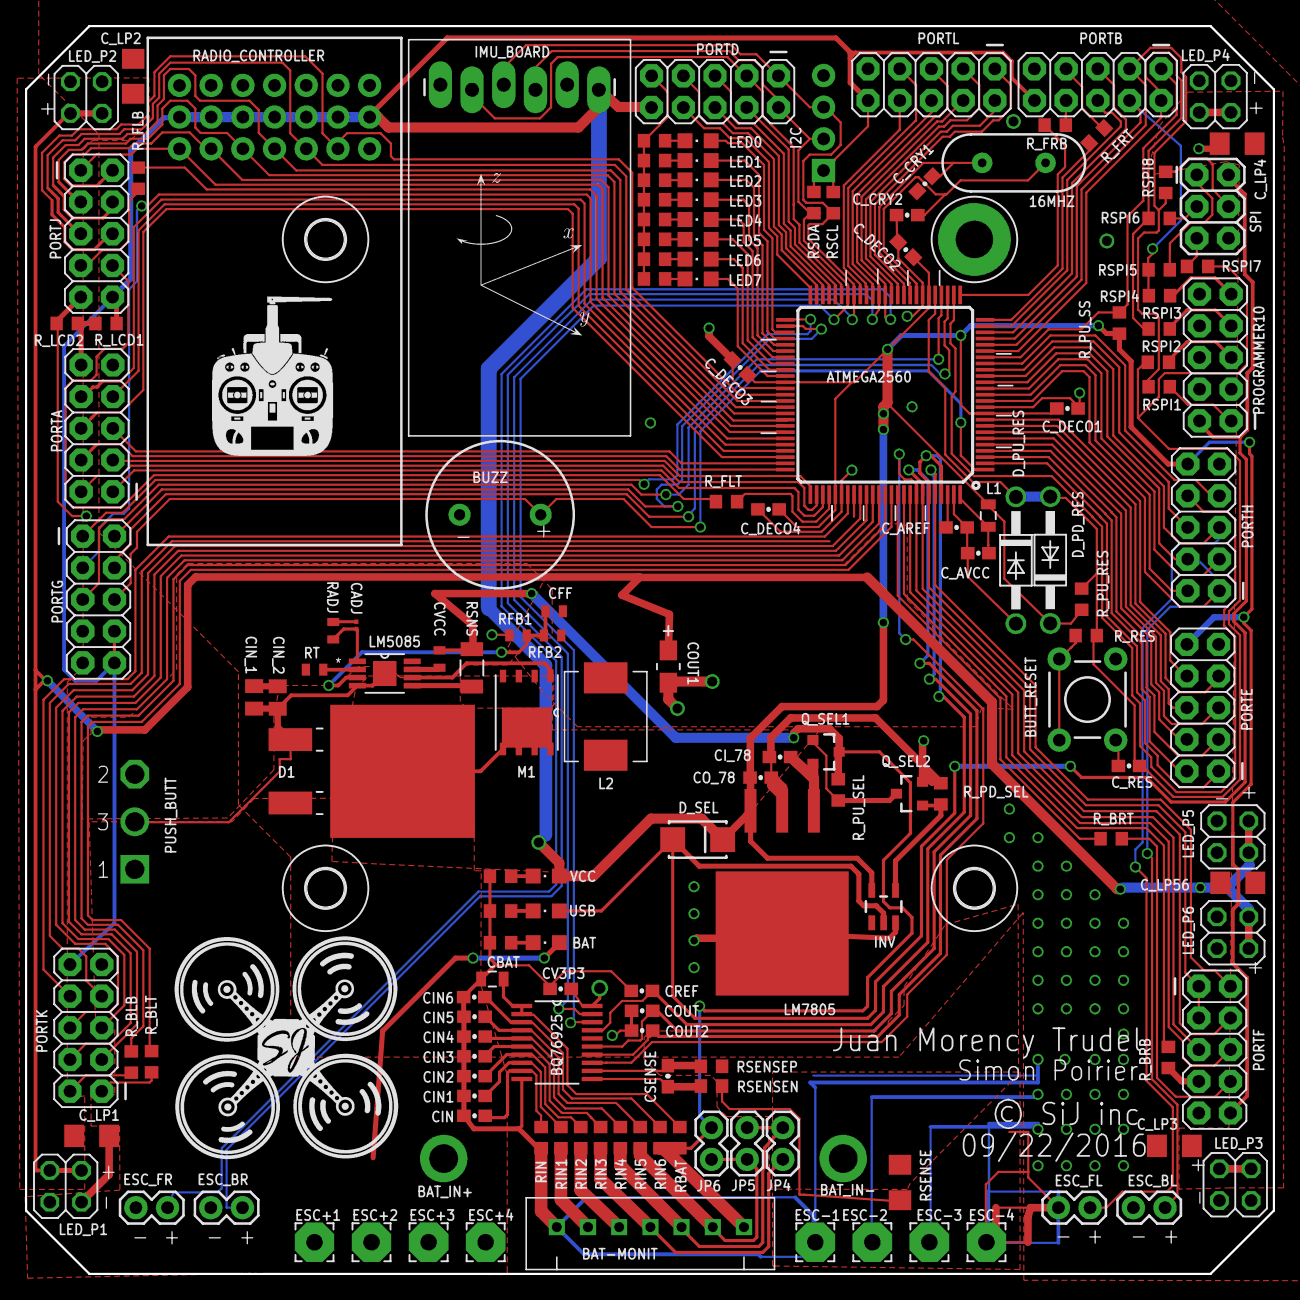
[picture p12: board Sij_Final.brd from above]

Board: 2 copper layers, 100.0 x 100.0 mm, 159 parts (0 on the bottom side), 152 nets.
