JuanMorency/Project_Sij/Eagle/LM5085/2016-09-12_10-49-24/2016-09-12_10-49-24.sch

## EAGLE design Eagle/LM5085/2016-09-12_10-49-24/2016-09-12_10-49-24.sch (2016-09-19)

Schematic: 2016-09-12_10-49-24.sch

Parts:
D1: 700mV; DDPAK
GND, GND2: WB_GND
L1: 2.2uH; XAL6030
M1: -30V; PowerPAK_SO-8
U1: LM5085MY/NOPB; MUY08A
