JuanMorency/Project_Sij/Code/Drone_V0.0/Drone_V0.0/controls.cpp

/**
******************************************************************************
* File Name         : controls.cpp
* Description       : Methods for the controls of the drone including PID controller.
* Author			: Juan Morency Trudel
* Version           : 1.0.0
* Date				: July 2017
******************************************************************************
*/

#include "controls.h"
