JuanMorency/Project_Sij/Code/Drone_V0.0/Drone_V0.0/controls.h

/**
******************************************************************************
* File Name         : controls.h
* Description       : Header file for controls.cpp
* Author			: Juan Morency Trudel
* Version           : 1.0.0
* Date				: July 2017
******************************************************************************
*/

#ifndef CONTROLS_H_
#define CONTROLS_H_

#include "RF.h"
#include "esc.h"
#include "IMU.h"
#include "PID.h"
#include "serial.h"

#endif /* CONTROLS_H_ */
