JuanMorency/Project_Sij/Code/Drone_V0.0/Drone_V0.0/RF.h

/**
******************************************************************************
* File Name         : RF.h
* Description       : Header for RF.cpp
* Author			: Juan Morency Trudel
* Version           : 1.0.0
* Date				: September 2016
******************************************************************************
*/

#ifndef RF_H
#define RF_H

#include <avr/interrupt.h>
#include <math.h>
#include "typeDef.h"
#include "filter.h"
#include "debugLED.h"
#include "serial.h"

// Hardcoded values of our RF receiver when offset control is centered
// might want to do a calibration script to obtain these values

#define CHANNEL_1_MIN_PWM 2222
#define CHANNEL_2_MIN_PWM 2104
#define CHANNEL_3_MIN_PWM 2200
#define CHANNEL_4_MIN_PWM 2053
#define CHANNEL_1_MAX_PWM 3946
#define CHANNEL_2_MAX_PWM 3799
#define CHANNEL_3_MAX_PWM 3540
#define CHANNEL_4_MAX_PWM 3957
#define CHANNEL_1_RANGE (CHANNEL_1_MAX_PWM-CHANNEL_1_MIN_PWM)
#define CHANNEL_2_RANGE (CHANNEL_2_MAX_PWM-CHANNEL_2_MIN_PWM)
#define CHANNEL_3_RANGE (CHANNEL_3_MAX_PWM-CHANNEL_3_MIN_PWM)
#define CHANNEL_4_RANGE (CHANNEL_4_MAX_PWM-CHANNEL_4_MIN_PWM)

//these were obtained by taking the mean of 100 values when the 
//joystick is in neutral position
#define CHANNEL_1_MEAN 3034
#define CHANNEL_2_MEAN 2936
#define CHANNEL_3_MEAN (CHANNEL_3_MAX_PWM+CHANNEL_3_MIN_PWM)/2
#define CHANNEL_4_MEAN 2976

#define DESIRED_YAW_SENSITIVITY_TO_RF_MULTIPLIER 0.01f
#define YAW_RF_THRESHOLD 30
#define PITCH_RF_THRESHOLD 20
#define ROLL_RF_THRESHOLD 20


#define MAX_ROLL_CONTROL 60 //in degrees
#define MAX_PITCH_CONTROL 60 //in degrees
#define MAX_YAW_CONTROL 120 //in degrees

#define CHANNEL_1_MULTIPLIER 2*MAX_ROLL_CONTROL/CHANNEL_1_RANGE
#define CHANNEL_2_MULTIPLIER 2*MAX_PITCH_CONTROL/CHANNEL_2_RANGE
#define CHANNEL_4_MULTIPLIER 2*MAX_YAW_CONTROL/CHANNEL_4_RANGE

#define MIN_PWM_DETECT 1500 

#define YAW 0
#define PITCH 1
#define ROLL 2

extern int16_t ch_1_pw, ch_2_pw, ch_3_pw, ch_4_pw;
extern bool RFInitialized;
extern uint8_t channel1OverflowCount, channel2OverflowCount, channel3OverflowCount, channel4OverflowCount;
extern 	bool flagRfOn;
extern bool rfActivity; 

void initRF();
void handleFSMRF(void);
float getDesiredAngleFromRf(uint8_t angleId);

#endif
