JuanMorency/Project_Sij/Code/Drone_V0.0/Drone_V0.0/lcd.h

/**
  ******************************************************************************
	* File Name			: lcd.h
	* Description		: Header for lcd.c
	* Author			: Auguste Lalande, Felix Dube, Juan Morency Trudel
	* Version			: 1.0.0
	* Date				: last modified September 4 2016
  ******************************************************************************
  */

#ifndef LCD_H
#define LCD_H

#ifndef F_CPU
#define F_CPU 16000000
#endif

#include <avr/io.h>
#include <util/delay.h>

#define RS 	PORTG0
#define RW 	PORTG1
#define E 	PORTG2
#define DB0 PORTA0
#define DB1 PORTA1
#define DB2 PORTA2
#define DB3 PORTA3
#define DB4 PORTA4
#define DB5 PORTA5
#define DB6 PORTA6
#define DB7 PORTA7

#define MAX_NUMBER_CHAR_LCD_DISPLAY 16
// Here the times are multiplied by 2 because the counter is at 0.5 us
#define ENABLE_TIME 100 						/* 50 us, don't set below ~50 or weird timing issue with display */
#define WAIT_TIME_AFTER_RESET 3000				/* 1500 us, don't set below ~1000 us*/

#define LINE2 64
#define LINE1 0


//States for LCD Display
#define CLEAR_STATE				0
#define WAIT_1_5_MS_STATE		1
#define LINE1_STATE				2
#define CHANGE_ADDRESS_STATE	3
#define LINE2_STATE				4
#define WAIT_STATE				5

extern char g_line1[20];
extern char g_line2[20];

extern bool lcdInitialized;

void initLCD(void);
void enable(void);
void LCD_WriteChar(char c);
void LCD_WriteString(char * string);
void clearDisplay(void);
void returnHome(void);
void inputMode(void);
void turnOn(void);
void functionSet(void);
void entryMode(void);
void SetAdress(int address);

void changeLCDText(char* line1, char* line2);
void changeLCDText(char* line1);

void handleFSMLCD(void);

#endif
