JuanMorency/Project_Sij/(commit log)

2016-07-02 Create Liste de materiel
2016-07-02 Update Liste de materiel
2016-07-02 Create Frame
2016-07-07 Update Liste de materiel
    LCD
2016-07-10 Create Battery
2016-07-10 J'ai mis un peu d'ordre et j'ai rajouté de la documentation
2016-07-26 Create Matériel circuit
    crystal trouvé
2016-07-31 allo j'ai change les noms
2016-07-31 bibliothèque eagle+script+projet
    [Sij.brd, Sij.sch]
2016-07-31 ajouté liste de magasinage Abra
2016-07-31 ajouté un fichier text avec le hardware qu'on utilise pour le power Management
2016-08-01 ajouté ma custom bibliotheque avec les trucs de TI
2016-08-01 Ajouté le gitignore pour des fichiers inutiles
2016-08-01 ajouté des pièces pour digikey
    [Sij.brd, Sij.sch]
2016-08-02 ajouté des bibliothèques de composantes, modifié beaucoup le schematic du pcb et ajouté des listes d'épicerie
    [Sij.brd, Sij.sch, SijV2.brd, SijV2.sch]
2016-08-03 ajusté les listes d'épicerie
2016-08-03 modifié le TODO
    [Sij.brd, Sij.sch, SijV2.brd, SijV2.sch]
2016-08-03 juste souligné quelques trucs dans la documentation
2016-08-05 joué avec le schematic et la commande digikey
    [Sij.brd, Sij.sch]
2016-08-05 documentation du IMU
2016-08-05 fini le schematic préliminaire+bibliothèques de partie+documentation
    [Sij.brd, Sij.sch]
2016-08-07 listes matériel
    [Sij.brd, Sij.sch]
2016-08-08 quelques ports ajoutés
    [Sij.brd, Sij.sch]
2016-08-15 quelques ports
    [Sij.brd, Sij.sch]
2016-08-25 ajouté un project pour tester ta configuration qui fait alterner le port D entre 0 et 5V, ajouté de la documentation
2016-08-25 ajouté la photo des connexions pour le board sans crystal
2016-08-25 J'ai travaillé sur le schematic du PCB. Pas mal final
    [Sij.brd, Sij.sch]
2016-08-26 joué un peu avec le layout
    [Sij.brd, Sij.sch]
2016-08-26 schematics PWM changé
2016-08-26 fichiers pour code ESC créés
    [Sij.brd, Sij.sch]
2016-08-28 registres PWM initialisés
2016-08-31 joué un peu avec le code PWM
2016-09-03 Ajouté les fonctionnlités d'un simple interrupt
2016-09-03 commencé le code pourlire le pwm du Radio controller et j'ai ajouté du code pour le LCD
2016-09-09 Modifié le PCB
    [Sij.brd, Sij.sch]
2016-09-12 presque terminé le layout. Après genre 20h de travail acharné!
    [Sij.brd, Sij.sch]
2016-09-19 PCB presque terminé
    [2016-09-12_10-49-24.sch, LM5085.sch, Sij.brd, Sij.sch, Sij2.brd, Sij2.sch]
2016-11-19 Added code for I2C and IMU
    [Sij2.brd, Sij2.sch, Sij_Final.brd, Sij_Final.sch]
2016-12-24 Ajouter le dernier eagle qui a été envoyé à la manufacture, le code pour le I2C préliminaire, le code pour le WS2812 led strip.
    [liste_comp_manquante.xlsx]
2016-12-24 Ajouter qulques fonctions a WS2812 + debut de documentation du code
2016-12-24 Added comments for I2C methods
2016-12-24 macro LED
2017-02-11 ajouter les interrupts,ISR et FSM pour LED, ESC, RF et LCD. J'ai aussi fait un peu de menage dans le git
    [liste_comp_manquante.xlsx]
2017-02-14 ajouté le interrupt pour le IMU. Testé le code et semble avoir un problème quand on lit plus d'une donné sur le IMU. Vérifier le code I2C
2017-02-17 Tentative de regler le probleme du IMU, on recoit seulement une fois les donnees et ensuite elle ne change plus, le IMU n'update plus ses valeurs... a tester sur un arduino pour voir si le senseur es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
    [I2C.cpp, I2C.h, IMU.cpp, IMU.h, interrupt.h, main.cpp]
2017-02-24 Fixed the I2C problem, Acc/Gyr now work
    [l.obj]
2017-02-25 Fixed the Magnetometer I2C issue. can read the address of the device right but the data seems to be off and does not change.
    [AK8963.cpp, AK8963.h, I2C.cpp, IMU.cpp, MPU9255.cpp, main.cpp]
2017-02-25 Added BMP180 class and minor fixes. Magnetometer still broken
    [AK8963.h, BMP180.cpp, BMP180.h, I2C.cpp, IMU.cpp, IMU.h, debugLED.h, interrupt.cpp]
2017-02-26 Fixed the Magnetometer problem, works great now
    [AK8963.cpp, AK8963.h, IMU.cpp, MPU9250_raw.ino, main.cpp]
2017-02-26 fixed the compilation error
    [MPU9255.cpp, MPU9255.h]
2017-02-27 Fixed the gyroscope calibration
    [IMU.cpp, IMU.h, MPU9255.cpp, MPU9255.h, main.cpp, typeDef.h]
2017-03-01 update calculation to avoid floats on AK8973. MPU180 has good pressure value but still has a couple issue mentionned on the trello. Rearranged folders
    [l.obj]
2017-03-02 Fixed the gyro Z problem with the new hardware
    [BMP180.cpp, IMU.cpp, MPU9255.cpp, main.cpp]
2017-06-01 Added Serial testing code. This should be added to the main project. Minor modifications of the IMU code
2017-06-05 Added Serial functionnalities to DroneV0.0. Fixed the barometer. Improved the serial formating.
    [l.obj]
2017-06-11 Added but did not integrate the Madwick Sensor fusion algorithm
2017-06-11 fixed RF problems and started the Madgwick integration
    [IMU.cpp, IMU.h, MadgwickAHRS.cpp, interrupt.cpp, main.cpp, serial.h]
2017-06-22 Fixed the Madgwick algo. Added a frequency counter for the IMU update rate. Added Euler angle conversion. Added a simple script for testing the ESCs. Other minor fixes. Removed permenantly LCD stuff.
    [BMP180.h, I2C.cpp, I2C.h, IMU.cpp, IMU.h, MadgwickAHRS.cpp, MadgwickAHRS.h, esc.h]
2017-07-11 I2C FSM now working completely. Fixed Yaw pitch roll positive direction. Fixed magnetic offsets. Changed BMP180 to object again and implemented it for I2C FSM
    [AK8963.cpp, AK8963.h, BMP180.cpp, BMP180.h, I2C.cpp, I2C.h, IMU.cpp, IMU.h]
2017-07-12 Added the PID controller and objects
2017-07-18 Optimized the PID and ESC controls. We can get around 200 Hz of Acc/Gyr and 100 Hz Mag update rate when the Serial is off and ESC is slowed down. This should be enough for most of the testing
2017-08-01 fixed the debug LED problems. Fixed the ESC shutdown when RF is off with the timeout. Added yaw variable to maintain yaw direction and change that variable with RF
    [AK8963.cpp, AK8963.h, I2C.cpp, IMU.cpp, MPU9255.cpp, MPU9255.h, PID.cpp, PID.h]
