JuanMorency/Project_Sij/(notices)

Notices in the files:
Eagle/Projects/Sij/Sij2.brd:
© SiJ inc
parts and their libraries:
SparkFun-Connectors: Licensing: Creative Commons ShareAlike 4.0 International - https://creativecommons.org/licenses/by-sa/4.0
